florensg/cansat-utn-frre/docs/README.md

# Documentación del proyecto CanSat

Índice de la documentación técnica y de gestión del equipo UTN FRRe para el CanSat
Universitario 2026-2027.

## Estructura

### 00-gestion

Planificación, roles y listas de elementos.

- [Participantes y roles](00-gestion/participantes.md)
- [Decisión: repositorio único privado](00-gestion/decision-repo-bootstrap.md)
- [Decisión: controlador principal ESP32-S3](00-gestion/decision-controlador-esp32s3.md)
- [Planificación General v3](00-gestion/planificacion-general-v3.xlsx) — **vigente**
- [Elementos del CanSat v2](00-gestion/elementos-cansat-v2.xlsx) — **vigente**
- [Versiones anteriores archivadas](00-gestion/archivo/) — solo histórico, no usar

### 01-requisitos

Bases del certamen, reglamento, Anexo A y requisitos técnicos.

- [Propuesta Etapa 2 (borrador)](01-requisitos/propuesta-etapa-2-borrador.docx)
- [Requisitos técnicos organizados](01-requisitos/requisitos-tecnicos-organizado.docx)
- [Documentos de la competencia](01-requisitos/competencia/)

### 02-arquitectura

Arquitectura general, diagramas de sistemas y propuesta de circuito.

- [Diagramas de arquitectura y estados](02-arquitectura/diagramas/)
- [Propuesta de circuito CanSat](02-arquitectura/propuesta-circuito-cansat.pdf) — borrador
  preliminar; el controlador vigente es el ESP32-S3 (Elementos v2, C-002).

### 03-subsistemas

Documentación por subsistema y responsabilidad.

- [Software de vuelo — ISI 1](03-subsistemas/software-vuelo/README.md)
- [Determinación de actitud — ISI 1](03-subsistemas/actitud/README.md)
- [Software de misión secundaria — ISI 1](03-subsistemas/secundaria/README.md)
- [Comunicaciones — IEM 3 / ISI 2](03-subsistemas/comunicaciones/)
- [Resumen de Ingeniería de Software (borrador)](03-subsistemas/software-vuelo/resumen-ingenieria-software-borrador.docx)

### 04-pruebas

Planes de ensayo, matrices de verificación y evidencias.

- [Plan y matriz de pruebas](04-pruebas/README.md)

### 05-pdr

Material de la Preliminary Design Review.

- [Checklist y evidencias PDR](05-pdr/README.md)

## Convenciones

- Los documentos se nombran en minúsculas, sin acentos y con guiones.
- Las versiones nuevas de un documento de planificación se agregan como archivo nuevo y se
  indica cuál es la vigente en este índice.
- Las evidencias de ensayos se guardan en `04-pruebas/evidencias/` con el formato
  `AAAA-MM-DD_descripcion.ext`.
- Los datos personales (DNI, fecha de nacimiento, correos) no se versionan en este
  repositorio.
