florensg/cansat-utn-frre/docs/00-gestion/archivo/README.md

# Versiones anteriores de planificación y elementos

Este directorio conserva las versiones reemplazadas. **No deben usarse** para tomar
decisiones de diseño.

## Vigentes

- [`../planificacion-general-v3.xlsx`](../planificacion-general-v3.xlsx)
- [`../elementos-cansat-v2.xlsx`](../elementos-cansat-v2.xlsx)

## Histórico

- [`planificacion-general-v2.xlsx`](planificacion-general-v2.xlsx)
- [`elementos-cansat.xlsx`](elementos-cansat.xlsx)

El controlador principal vigente es el **ESP32-S3 DevKitC-1 de 44 pines** (C-002). El
STM32 (C-001) está descartado. Ver
[`../decision-controlador-esp32s3.md`](../decision-controlador-esp32s3.md).
