florensg/cansat-utn-frre/docs/03-subsistemas/comunicaciones/actividad-7-comunicaciones.docx

## Estructura del Documento de la Actividad 7

1. Introducción y Objetivos
2. Selección de Banda de Frecuencia
3. Selección del Módulo de Radio
4. Selección de Antenas (CanSat y Estación Terrena)
5. Cálculo del Balance de Enlace (Link Budget)
6. Configuración de Red (NetID/PanID)
7. Diagrama de Arquitectura del Enlace
8. Conclusiones y Justificación

## 1. Introducción y Objetivos

### 1.1 Introducción

El presente documento describe el diseño preliminar del subsistema de comunicaciones del CanSat correspondiente al certamen CANSAT Universitario 2026–2027, organizado por la Comisión Nacional de Actividades Espaciales (CONAE). Este subsistema es el encargado de establecer el enlace inalámbrico bidireccional entre la carga útil embarcada y la estación terrena, garantizando la transmisión de telemetría durante todas las fases de la misión y la recepción de telecomandos desde tierra.

El correcto funcionamiento del subsistema de comunicaciones es condición necesaria para el cumplimiento de la misión, ya que de él dependen:

- La verificación en tiempo real de los parámetros de vuelo exigidos por CONAE (altitud, presión, temperatura, voltaje, corriente, actitud, posición GPS, entre otros).
- La capacidad de enviar comandos críticos como la calibración de altitud a cero (CAL), la configuración de hora (ST) y la activación de mecanismos (MEC).
- La evidencia de la activación de los sistemas de descenso, que será evaluada por los jueces a partir de los archivos .csv generados por la estación terrena.

El diseño propuesto debe cumplir con los requisitos del Apéndice A – Requisitos de Misión y las Bases y Condiciones del certamen, en particular:

- X1: Uso exclusivo de frecuencias autorizadas por ENACOM: 915–928 MHz o 2400–2483.5 MHz.
- X2: Configuración del NetID/PanID con el número de equipo asignado.
- X3: Prohibición del modo de difusión (broadcast).
- X4: Activación automática de la telemetría al separarse del cohete.
- X5: Transmisión de telemetría a 1 Hz.
- X6: Inclusión obligatoria de altitud, presión, temperatura y coordenadas GPS (latitud, longitud, altitud y número de satélites).
- X7: Transmisión del estado de la batería y de la señal recibida por los paneles solares mediante telecomando.
- C9: Costo del CanSat inferior a $1.000.000 ARS.

Adicionalmente, el subsistema debe integrarse con los demás subsistemas del CanSat (adquisición de datos, control y software de vuelo, energía y estación terrena), respetando las restricciones de masa, volumen, consumo energético y compatibilidad electromagnética.

### 1.2 Objetivos

#### Objetivo general

Diseñar y justificar el subsistema de comunicaciones del CanSat, definiendo la banda de frecuencia, el módulo de radio, las antenas y el balance preliminar de enlace, de modo que se garantice un enlace inalámbrico bidireccional confiable, robusto y compatible con la normativa vigente durante todas las fases de la misión.

#### Objetivos específicos

1. Seleccionar la banda de frecuencia de operación entre las autorizadas por ENACOM (915–928 MHz o 2400–2483.5 MHz), justificando la elección en función del alcance requerido, la robustez del enlace, el consumo energético y la compatibilidad con el entorno de operación.
2. Seleccionar el módulo de radio a embarcar en el CanSat, comparando alternativas comerciales en términos de potencia de transmisión, sensibilidad de recepción, consumo, interfaz de comunicación, masa, dimensiones y costo.
3. Definir las antenas del CanSat y de la estación terrena, especificando tipo, ganancia, polarización, ubicación e integración mecánica, asegurando que no se produzcan apantallamientos ni interferencias con otros subsistemas.
4. Calcular el balance preliminar de enlace RF para la distancia máxima prevista, determinando la potencia recibida y el margen de enlace, y verificando que dicho margen sea suficiente para garantizar la transmisión confiable de telemetría a 1 Hz.
5. Definir la configuración de red (NetID/PanID) y las condiciones de operación del enlace, asegurando el cumplimiento del requisito X2 y la prohibición del modo broadcast (X3).
6. Elaborar la documentación técnica preliminar que servirá de base para las etapas posteriores del certamen (CDR, FRR y campaña de lanzamiento), incluyendo diagramas de arquitectura, tablas de parámetros y justificación de las decisiones adoptadas.

## 2. Selección de Banda de Frecuencia

### 2.1 Bandas autorizadas por ENACOM

El Apéndice A – Requisitos de Misión establece en el requisito X1 que las radios del CanSat deben operar exclusivamente en las frecuencias autorizadas por ENACOM:

- 915 – 928 MHz
- 2400 – 2483.5 MHz

Ambas bandas están declaradas de uso compartido en el territorio nacional y no requieren autorización para su uso. La Resolución Sintetizada 4653/2019 del ENACOM dispuso que las estaciones radioeléctricas que operen en estas bandas deben cumplir con los límites de potencia establecidos.

Según la normativa vigente, la potencia media conducida máxima para ambas bandas es de 30 dBm (1 W). Además, la anchura de banda ocupada debe ser de al menos 500 kHz para ambas bandas.

### 2.2 Comparación técnica entre 915 MHz y 2.4 GHz

Para seleccionar la banda de operación, se comparan ambas alternativas en función de los parámetros críticos para la misión del CanSat:

Parámetro | 915 MHz | 2400 MHz
Pérdida de espacio libre (1 km) | ~91.5 dB | ~100 dB
Alcance relativo | ~2× mayor que 2.4 GHz | Referencia
Penetración en obstáculos | Mayor | Menor
Ancho de banda disponible | Menor | Mayor
Interferencia | Baja | Alta (WiFi, Bluetooth, microondas)
Consumo de energía | Menor (LoRa) | Mayor
Tamaño de antena | Mayor (λ/4 ≈ 8.2 cm) | Menor (λ/4 ≈ 3.1 cm)
Módulos comerciales | SX1262, RFM95, XBee-PRO 900HP | ESP32, XBee S2C

La diferencia fundamental radica en la pérdida de espacio libre (FSPL). Según la fórmula:

Para una distancia de 1 km:

- 915 MHz: FSPL ≈ 91.5 dB
- 2400 MHz: FSPL ≈ 100 dB

Esto significa que la señal de 2.4 GHz sufre aproximadamente 8.5 dB más de pérdida que la de 915 MHz para la misma distancia. En la práctica, un sistema a 915 MHz puede alcanzar el doble de distancia que un sistema comparable a 2.4 GHz.

### 2.3 Análisis de propagación en el entorno de operación

El CanSat será lanzado a más de 500 m de altura y descenderá en un entorno rural o semi-rural (Centro Espacial Teófilo Tabanera, Falda del Cañete, Córdoba). Durante el descenso, la antena del CanSat tendrá una línea de visión directa (LOS) hacia la estación terrena, pero deberá atravesar:

- Distancia de enlace: mínimo 1 km, idealmente 3–5 km.
- Posible obstrucción por vegetación, relieve del terreno o el propio cuerpo del CanSat.
- Rotación del CanSat durante el descenso (la antena debe ser omnidireccional o tener un patrón que cubra todas las orientaciones).

La banda de 915 MHz ofrece mejor penetración en obstáculos y mayor robustez frente a desvanecimientos por multitrayecto, lo cual es crítico para garantizar la continuidad de la telemetría durante todo el descenso.

### 2.4 Justificación de la selección: 915 MHz

Se selecciona la banda de 915 – 928 MHz por las siguientes razones:

1. Mayor alcance: Para la misma potencia de transmisión y ganancia de antenas, el enlace a 915 MHz tiene aproximadamente 8.5 dB menos de pérdida que a 2.4 GHz, lo que se traduce en un alcance significativamente mayor.
2. Menor consumo energético: Los módulos LoRa que operan en 915 MHz (como el SX1262) tienen consumos típicos de ~4.6 mA en recepción y ~118 mA en transmisión a +22 dBm, con corrientes de reposo del orden de 1–2 µA. Esto es crítico para cumplir con el requisito E7 de 2 horas de autonomía.
3. Robustez del enlace: La banda de 915 MHz presenta menor interferencia que 2.4 GHz, que es compartida con WiFi, Bluetooth y otros dispositivos de uso masivo.
4. Disponibilidad de módulos y antenas: Existen módulos comerciales ampliamente disponibles en Argentina, como el SX1262, que operan en 915 MHz y son compatibles con microcontroladores como el STM32.
5. Compatibilidad con normativa ENACOM: La banda de 915–928 MHz está declarada de uso compartido y permite potencias de hasta 30 dBm, suficiente para el enlace requerido.
6. Experiencia previa en competencias CanSat: Proyectos anteriores de CanSat han utilizado exitosamente la banda de 915 MHz con módulos LoRa y antenas dipolo omnidireccionales, alcanzando distancias de 2.8–4.3 km en condiciones de línea de visión.

### 2.5 Conclusión de la sección

La banda de 915 – 928 MHz es la opción técnicamente superior para el subsistema de comunicaciones del CanSat, ofreciendo mayor alcance, menor consumo energético, mejor penetración en obstáculos y menor interferencia que la alternativa de 2.4 GHz. Esta selección es compatible con la normativa ENACOM y con los requisitos de misión establecidos por CONAE.

## 3. Selección del Módulo de Radio

### 3.1 Introducción

Definida la banda de operación en 915–928 MHz (Sección 2), el siguiente paso es seleccionar el módulo de radio que se embarcará en el CanSat y el que se utilizará en la estación terrena. El módulo debe cumplir con los siguientes criterios derivados de los requisitos de misión:

- Potencia de transmisión suficiente para garantizar el enlace a la distancia prevista.
- Sensibilidad de recepción compatible con el balance de enlace calculado.
- Consumo energético compatible con el requisito E7 (2 horas de autonomía).
- Interfaz de comunicación compatible con el microcontrolador STM32 seleccionado (SPI o UART).
- Disponibilidad comercial en Argentina o con importación viable.
- Costo dentro del presupuesto del CanSat (< $1.000.000 ARS).

Nota: La selección de antenas se desarrolla en la Sección 4: Selección de Antenas. En esta sección solo se define el módulo de radio y los componentes eléctricos asociados a su conexión (cables, conectores), sin incluir antenas.

### 3.2 Candidatos evaluados

Se evaluaron tres módulos representativos del mercado:

Módulo | Chip base | Fabricante | Interfaz
SX1262 | SX1262 | Semtech | SPI
SX1276 (RFM95) | SX1276 | Semtech / HopeRF | SPI
XBee-PRO 900HP | ADF7023 | Digi International | UART / SPI

### 3.3 Comparación técnica

Parámetro | SX1262 | SX1276 (RFM95) | XBee-PRO 900HP
Potencia TX máx. | +22 dBm | +20 dBm | +24 dBm
Sensibilidad RX | -136.7 dBm @ SF12, BW125 | -148 dBm (típica) | -110 a -101 dBm
Corriente RX | 4.2–4.6 mA | 10.8–12 mA | 29–60 mA
Corriente TX (@ máx.) | 118 mA @ +22 dBm | 120 mA @ +20 dBm | 215 mA
Corriente Sleep | 1.62 µA | 0.2 µA | 2.5 µA
Tensión de operación | 1.8–3.9 V | 1.8–3.7 V | 2.1–3.6 V
Modulación | LoRa, FSK | LoRa, FSK, GFSK, OOK | FHSS (Frequency Hopping)
Alcance LOS (típico) | 10 km+ | ~15 km (depende de configuración) | 9–14 km con dipolo
Complejidad de firmware | Media (SPI, requiere driver) | Media (SPI, requiere driver) | Baja (UART, comandos AT)
Costo unitario (aprox.) | ~$8–12 USD | ~$5–8 USD | ~$39–42 USD
Disponibilidad en Argentina | Importación (Tiendamia, etc.) | Disponible localmente (RFM95CW) | Importación

### 3.4 Análisis de consumo energético

El consumo es un factor crítico debido al requisito E7 (2 horas de autonomía mínima integrado en el cohete). A continuación se estima el consumo promedio del módulo de radio en cada fase de misión:

Fase | Duración estimada | Estado del radio | Consumo (SX1262) | Consumo (SX1276) | Consumo (XBee-PRO)
STAND-BY (en cohete) | ~2 h | Sleep | 1.62 µA | 0.2 µA | 2.5 µA
Ascenso | ~1–2 min | RX/TX intermitente | ~5 mA | ~11 mA | ~30 mA
Descenso | ~3–5 min | TX @ 1 Hz | ~118 mA (pico) / ~5 mA (promedio) | ~120 mA (pico) / ~10 mA (promedio) | ~215 mA (pico) / ~30 mA (promedio)
Post-aterrizaje | Variable | TX @ 1 Hz | ~118 mA (pico) / ~5 mA (promedio) | ~120 mA (pico) / ~10 mA (promedio) | ~215 mA (pico) / ~30 mA (promedio)

Conclusión del análisis: El SX1262 presenta el menor consumo en recepción (4.2 mA vs 10.8 mA del SX1276 y 29–60 mA del XBee-PRO), lo cual es crítico durante las fases de ascenso y descenso, donde el radio debe estar escuchando comandos de la estación terrena. Además, su corriente de sleep (1.62 µA) es compatible con las 2 horas de STAND-BY requeridas.

### 3.5 Disponibilidad y costo en Argentina (Mercado Libre)

Se realizó una búsqueda de los módulos y componentes eléctricos asociados en Mercado Libre Argentina. Los resultados se resumen a continuación:

Componente | Especificaciones | Precio (ARS) | Fuente
Módulo LoRa para Raspberry Pi Pico SX1262 915 MHz + batería | SX1262, 915 MHz, incluye batería | $51.975 | Mercado Libre
Cable Pigtail U.FL/IPX a SMA, 15 cm | Cable de conexión antena | $3.990 | Mercado Libre
Conector Adaptador SMA Macho a 2 SMA Hembra en T | Adaptador para derivación de antena | $8.171,49 | Mercado Libre

Observaciones:

- El módulo SX1262 para Raspberry Pi Pico ($51.975) es una solución integrada que incluye el chip SX1262, regulación de tensión y conector de antena IPEX. Es ideal para el CanSat, ya que simplifica la integración con el microcontrolador STM32 (vía SPI). Nota: La batería incluida debe verificarse; si es de polímero de litio (LiPo), no cumple con el requisito E1 y debe reemplazarse por una 18650, Ni-MH o alcalina.
- El cable pigtail U.FL/IPX a SMA ($3.990) es necesario para conectar el módulo SX1262 (conector IPEX) a la antena (conector SMA). Se recomienda adquirir al menos un repuesto.
- El conector adaptador SMA macho a 2 SMA hembra en T ($8.171,49) permite derivar la señal de antena hacia dos receptores (por ejemplo, para monitoreo con analizador de espectro durante las pruebas). No es necesario durante el vuelo.

Costo total del subsistema de radio (sin antenas):

Ítem | Cantidad | Precio unitario (ARS) | Subtotal (ARS)
Módulo SX1262 (CanSat) | 1 | $51.975 | $51.975
Módulo SX1262 (GCS) | 1 | $51.975 | $51.975
Cable pigtail U.FL/IPX a SMA (repuesto) | 1 | $3.990 | $3.990
Conector adaptador SMA macho a 2 SMA hembra en T | 1 | $8.171,49 | $8.171,49
TOTAL (sin antenas) | | | $116.111,49

### 3.6 Justificación de la selección: SX1262

Se selecciona el SX1262 como módulo de radio para el CanSat y la estación terrena, por las siguientes razones:

1. Menor consumo en recepción: 4.2 mA frente a 10.8 mA del SX1276 y 29–60 mA del XBee-PRO. Esto extiende la autonomía de la batería, cumpliendo con mayor margen el requisito E7.
2. Mejor sensibilidad efectiva: Aunque el SX1276 tiene una sensibilidad nominal de -148 dBm, el SX1262 alcanza -136.7 dBm en condiciones reales con SF12 y BW125, suficiente para el enlace previsto. La diferencia de 11 dB es compensable con ganancia de antena o potencia de transmisión.
3. Potencia de transmisión superior: +22 dBm frente a +20 dBm del SX1276. Esto proporciona 2 dB adicionales de margen de enlace.
4. Corriente de sleep ultra baja: 1.62 µA, ideal para el modo STAND-BY durante las 2 horas previas al lanzamiento.
5. Tecnología actual: El SX1262 es el chip estándar de facto para nuevas aplicaciones LoRa, con mayor soporte de la comunidad y documentación más reciente.
6. Disponibilidad comprobada en Argentina: El módulo SX1262 para Raspberry Pi Pico está disponible en Mercado Libre a $51.975, con stock inmediato y envío nacional. Esto elimina la necesidad de importación y reduce tiempos de entrega.

Consideración sobre el SX1276: Aunque el SX1276 (RFM95) está disponible localmente a menor costo (~ 22.000– 26.000), su mayor consumo en recepción (10.8 mA) y su menor potencia de transmisión (+20 dBm) lo hacen menos eficiente para una misión donde la autonomía es crítica. El ahorro de costo no compensa el mayor consumo energético ni la menor potencia.

### 3.7 Módulo específico recomendado

Se recomienda el uso del Módulo LoRa para Raspberry Pi Pico SX1262 915 MHz disponible en Mercado Libre, cuyas especificaciones principales se resumen a continuación:

Parámetro | Valor
Chip | SX1262
Frecuencia | 915 MHz
Potencia TX | +22 dBm
Sensibilidad RX | -136.7 dBm @ SF12, BW125
Corriente sleep | 1.62 µA
Interfaz | SPI
Incluye | Batería, conector de antena IPEX
Precio | $51.975 ARS
Disponibilidad | Mercado Libre Argentina

Nota: La antena asociada a este módulo se define en la Sección 4: Selección de Antenas.

### 3.8 Conclusión de la sección

El SX1262 es el módulo de radio seleccionado para el subsistema de comunicaciones del CanSat. Ofrece el mejor equilibrio entre consumo energético, sensibilidad, potencia de transmisión y disponibilidad en el mercado argentino, cumpliendo con los requisitos de misión y normativa ENACOM. El costo total del subsistema de radio (dos módulos, cables y conectores, sin antenas) asciende a **$116.111,49 ARS**, lo cual es compatible con el presupuesto del CanSat (< $1.000.000 ARS).

# 4. Selección de Antenas (CanSat y Estación Terrena)

## 4.1 Introducción

Definido el módulo de radio SX1262 (Sección 3), el siguiente paso es seleccionar las antenas que completan el enlace RF. La antena es un componente crítico porque determina la ganancia del sistema, el patrón de radiación y la eficiencia de la conversión entre la señal eléctrica y la onda electromagnética. A diferencia del módulo de radio, la antena no puede seleccionarse únicamente por sus especificaciones eléctricas: su tamaño, masa, resistencia mecánica y ubicación físicacondicionan el diseño del CanSat.

Los requisitos aplicables son:

- S1: Masa combinada del CanSat y contenedor: 500 g ± 10 g. La antena contribuye a este presupuesto.
- S2: Diámetro del CanSat: 95 mm. La antena no puede exceder este diámetro en su sección transversal.
- S3: Longitud total: 200–250 mm. La antena debe integrarse dentro de este volumen o desplegarse sin excederlo.
- X1: Frecuencia: 915–928 MHz.
- G11: La antena de la estación terrena debe ser de mesa o portátil.

## 4.2 Consideraciones de propagación y orientación

Durante el descenso, el CanSat rota de forma no controlada alrededor de sus tres ejes. Esto significa que la antena del CanSat debe tener un patrón de radiación omnidireccional en el plano horizontal, de modo que el enlace no se pierda cuando el CanSat gira. Una antena dipolo con patrón omnidireccional de 360° en el plano H (horizontal) garantiza conectividad independientemente de la orientación del CanSat.

En la estación terrena, el operador puede apuntar manualmente una antena direccional de mayor ganancia hacia la posición prevista del CanSat. Durante el ascenso y el descenso, la trayectoria es aproximadamente vertical sobre el sitio de lanzamiento, por lo que una antena direccional con un ancho de haz de 30–45° es suficiente para mantener el enlace sin necesidad de seguimiento motorizado.

## 4.3 Antena del CanSat

### 4.3.1 Selección: Antena omnidireccional 868/915 MHz con pigtail IPEX a SMA

Se selecciona la Antena LoRa 868/915 MHz + Pigtail IPEX/U.FL a SMA Hembra, disponible en Mercado Libre Argentina por $7.500. Esta antena incluye:

- Antena omnidireccional de 868/915 MHz.
- Cable pigtail IPEX/U.FL a SMA hembra de panel.
- Compatible con módulos que utilicen conector IPEX/U.FL (como el SX1262 seleccionado en la Sección 3).

Justificación: El patrón omnidireccional de esta antena garantiza cobertura de 360° en el plano horizontal, lo cual es esencial durante el descenso del CanSat, cuando la orientación no está controlada. Su conector IPEX/U.FL es directamente compatible con el módulo SX1262. El precio es significativamente menor que otras alternativas comerciales.

Alternativa: Si se requiere una antena de menor perfil para el CanSat, puede utilizarse una antena dipolo impresa en PCB de 2 dBi con conector U.FL. Estas antenas tienen masa inferior a 2 g y se integran directamente en la placa del CanSat, eliminando el cable pigtail y reduciendo pérdidas.

### 4.3.2 Especificaciones técnicas

Parámetro | Valor
Tipo | Omnidireccional
Frecuencia | 868 / 915 MHz
Ganancia | ~2 dBi (típica para este tipo)
Impedancia | 50 Ω
Polarización | Lineal (vertical)
Patrón (plano H) | Omnidireccional 360°
Conector de antena | SMA macho
Pigtail incluido | IPEX/U.FL a SMA hembra de panel
Masa | ~5–10 g (incluyendo pigtail)
Precio | $7.500 ARS

### 4.3.3 Ubicación e integración mecánica

La antena del CanSat debe ubicarse de modo que su campo de visión hacia la estación terrena esté libre de obstáculos metálicos. La estructura del CanSat, la batería 18650 y los componentes electrónicos pueden actuar como planos de masa o apantallar la señal si la antena queda demasiado próxima a ellos.

Criterios de ubicación:

1. Extremo superior o inferior del cilindro: La antena debe montarse en uno de los extremos del CanSat, alejada de la batería y de las placas de circuito impreso. Esto minimiza el acoplamiento capacitivo con el cuerpo del CanSat.
2. Orientación vertical: La antena debe orientarse paralela al eje longitudinal del CanSat. Con esta orientación, el patrón omnidireccional del dipolo cubre el plano horizontal (donde se encuentra la estación terrena) durante el descenso estabilizado.
3. Separación de la batería: La batería 18650 es un objeto metálico de gran volumen. La antena debe mantenerse a una distancia mínima de λ/4 ≈ 8.2 cm de la batería para evitar desintonización y pérdida de eficiencia.
4. Fijación: La antena se fija mediante un soporte impreso en 3D que la sujeta sin ejercer tensión sobre el conector IPEX. El cable pigtail debe fijarse con adhesivo o bridas para evitar que las vibraciones (15 G) y el choque (30 G) lo desconecten.
5. Protección: Si la antena queda expuesta al exterior, debe protegerse con un radomo de material dieléctrico (PLA, PETG o ABS) que no atenúe la señal a 915 MHz.

## 4.4 Antena de la Estación Terrena

### 4.4.1 Selección: Yagi direccional de alta ganancia

Para la estación terrena se selecciona una antena Yagi direccional. Se evaluaron dos opciones disponibles en Mercado Libre:

Opción | Modelo | Ganancia (nominal) | Precio (ARS)
Opción A | Yagi 35 dBi 900 MHz (Ubiquiti) | 35 dBi | $69.800
Opción B | Yagi 24 dBi 900 MHz (Ubiquiti) | 24 dBi | $48.900

Observación crítica sobre la ganancia: Los valores de 35 dBi y 24 dBi indicados en las publicaciones son inusualmente altos para antenas Yagi. Las antenas Yagi comerciales para 900 MHz suelen tener ganancias comprendidas entre 10 dBi y 17 dBi. Una ganancia de 35 dBi corresponde típicamente a antenas parabólicas de gran diámetro, no a Yagis. Es probable que el vendedor haya exagerado los valores o que se trate de antenas de otro tipo. Se recomienda verificar la ganancia real con el vendedor antes de la compra. Para el balance de enlace (Sección 5), se asumirá un valor conservador de 14.5 dBi, que es el valor típico de una Yagi de 900 MHz con múltiples elementos.

Selección preliminar: Se selecciona la **Opción B (Yagi 24 dBi, $48.900)** por su menor costo y porque, incluso asumiendo una ganancia real de 14.5 dBi, es suficiente para el balance de enlace. La Opción A (35 dBi, $69.800) ofrece mayor ganancia nominal pero a un costo 43% superior, sin garantía de que la ganancia real sea significativamente mayor.

Nota: La publicación indica que no incluye cable ni fichas. El vendedor ofrece colocar la ficha según el dispositivo a usar, con costo adicional. Se debe consultar al vendedor por el tipo de conector (SMA o N) y el costo del cable.

### 4.4.2 Especificaciones técnicas (asumidas)

Parámetro | Valor
Tipo | Yagi direccional
Frecuencia | 900–920 MHz
Ganancia (asumida) | 14.5 dBi
Impedancia | 50 Ω
Polarización | Lineal (horizontal o vertical, seleccionable)
Ancho de haz (plano H) | ~35°
Ancho de haz (plano V) | ~40°
Relación frente/espalda | >18 dB
Conector | A definir (SMA o N)
Masa | ~500–800 g
Precio | $48.900 ARS

### 4.4.3 Ubicación y montaje

La antena de la GCS debe montarse sobre un soporte de mesa o trípode para cumplir con el requisito G11. El operador apuntará la antena manualmente hacia la posición del CanSat durante el ascenso y el descenso.

Requisitos de montaje:

1. Altura: La antena debe elevarse al menos 1.5–2 m sobre el suelo para minimizar el efecto del terreno y de obstáculos cercanos (personas, vehículos, equipos).
2. Orientación: La polarización debe coincidir con la de la antena del CanSat. Si la antena del CanSat está polarizada verticalmente, la Yagi debe montarse con polarización vertical. El desajuste de polarización introduce una pérdida de hasta 3 dB.
3. Apuntamiento: El operador debe apuntar la Yagi hacia el CanSat. Dado que el CanSat asciende y desciende aproximadamente sobre el sitio de lanzamiento, el ángulo de elevación de la antena debe ajustarse progresivamente. Una Yagi con ancho de haz de 35° no requiere seguimiento preciso.
4. Cableado: Se utilizará cable coaxial de 50 Ω de baja pérdida. Atención: el cable RG-59 listado en Mercado Libre es de 75 Ω, no de 50 Ω. No es adecuado para este sistema, ya que introduciría desadaptación de impedancia y pérdidas adicionales. Se debe usar cable RG-213 Foam (50 Ω), cuyas pérdidas típicas a 915 MHz son de aproximadamente 0.15 dB/m (0.75 dB en 5 m).

## 4.5 Conectorización y cableado

### 4.5.1 CanSat

El módulo SX1262 (Sección 3) tiene un conector IPEX/U.FL hembra. La antena seleccionada incluye un cable pigtail con conector IPEX/U.FL macho en un extremo y SMA hembra en el otro.

Componentes de conexión:

Componente | Cantidad | Precio unitario (ARS) | Subtotal (ARS)
Antena LoRa 868/915 MHz + pigtail IPEX a SMA hembra | 1 | $7.500 | $7.500
Cables pigtail U.FL/IPEX a SMA hembra 5 cm (pack ×4) | 1 | $17.361,05 | $17.361,05
Conector adaptador SMA macho a 2 SMA hembra en T | 1 | $8.171,49 | $8.171,49
Total conexión CanSat | | | $33.032,54

Nota sobre el adaptador en T: El adaptador SMA macho a 2 SMA hembra en T permite derivar la señal de antena hacia dos receptores. Esto es útil si se desea monitorear la señal con un analizador de espectro durante las pruebas, pero no es necesario durante el vuelo. Para el vuelo, se recomienda conectar la antena directamente al módulo SX1262 sin adaptadores intermedios, para minimizar pérdidas y puntos de falla.

Nota sobre los cables pigtail: El pack de 4 cables pigtail U.FL/IPEX a SMA hembra de 5 cm ($17.361,05) es útil como repuesto y para pruebas. Para el vuelo, se utiliza el pigtail incluido con la antena.

### 4.5.2 Estación Terrena

La antena Yagi de la GCS se conecta a la radio de la GCS (módulo SX1262) mediante un cable coaxial de 50 Ω de baja pérdida. Se seleccionó el siguiente conjunto de componentes:

Componente | Cantidad | Precio unitario (ARS) | Subtotal (ARS)
Antena Yagi 24 dBi 900 MHz | 1 | $48.900 | $48.900
Cable Coaxil RG-213 Foam Baja Pérdida (rollo 10 m) | 1 | $96.500 | $96.500
Conector N Macho Crimp RG-213 | 2 | $8.900 | $17.800
Adaptador SMA Hembra a N Macho | 1 | $16.035,46 | $16.035,46
Total conexión GCS | | | $179.235,46

Nota sobre el adaptador SMA Hembra a N Macho: Este adaptador se utiliza para conectar el cable RG-213 (que tiene conector N macho) al módulo SX1262 de la GCS (que tiene conector SMA hembra). El adaptador tiene SMA hembra en un extremo y N macho en el otro. Sin embargo, se debe verificar la compatibilidad: si el cable RG-213 tiene conector N macho, para conectarlo al adaptador se necesita que el adaptador tenga N hembra, no N macho. En ese caso, el adaptador correcto sería N hembra a SMA macho. Se recomienda confirmar con el vendedor el género exacto de los conectores antes de la compra.

Alternativa: Si el cable RG-213 se adquiere con conectores N macho en ambos extremos, y el módulo SX1262 tiene SMA hembra, se necesita un adaptador N hembra a SMA macho. Si el adaptador disponible es SMA hembra a N macho, no servirá directamente. Se debe buscar el adaptador correcto o comprar el cable con un conector SMA macho en un extremo.

Nota sobre el cable RG-213 Foam: El rollo de 10 m permite cortar 5 m para el cable de la GCS y dejar 5 m de repuesto. La pérdida en 5 m es de aproximadamente 0.75 dB, lo cual es excelente.

## 4.6 Resumen del subsistema de antenas

Parámetro | CanSat | Estación Terrena
Tipo | Omnidireccional | Yagi direccional
Ganancia | ~2 dBi | 14.5 dBi (asumida)
Polarización | Lineal vertical | Lineal vertical (seleccionable)
Patrón | Omnidireccional 360° (H) | Direccional (35° H / 40° V)
Conector | IPEX/U.FL a SMA | SMA o N
Masa | ~5–10 g | ~500–800 g
Precio | $7.500 | $48.900

Costo total del subsistema de antenas (CanSat + GCS): ~$56.400 ARS (sin incluir cables ni conectores).

Costo total del subsistema de comunicaciones (radio + antenas + cables):

Ítem | Subtotal (ARS)
Módulos SX1262 (×2) + cables + conectores (Sección 3) | $116.111,49
Antena CanSat + pigtail + adaptador | $33.032,54
Antena GCS Yagi + cable RG-213 + conectores + adaptador | $179.235,46
TOTAL | ~$328.379,49

## 4.7 Conclusión de la Sección 4

Se seleccionan una antena omnidireccional de 868/915 MHz para el CanSat y una antena Yagi direccional para la estación terrena. La antena del CanSat garantiza conectividad omnidireccional durante el descenso, mientras que la Yagi de la GCS proporciona la ganancia necesaria para maximizar el margen de enlace.

Advertencias para la PDR:

1. Verificar la ganancia real de la Yagi con el vendedor. Los valores de 24 dBi y 35 dBi son sospechosamente altos para una Yagi. Si la ganancia real es inferior a 14.5 dBi, el balance de enlace de la Sección 5 deberá recalcularse.
2. No utilizar cable RG-59 (75 Ω). Se seleccionó RG-213 Foam (50 Ω) por su baja pérdida (0.75 dB en 5 m).
3. Confirmar el tipo de conector de la antena Yagi (SMA o N) y del módulo SX1262 (SMA hembra) para adquirir el adaptador correcto. El adaptador listado (SMA hembra a N macho) podría no ser el adecuado; verificar género.
4. Verificar que el módulo SX1262 tenga conector IPEX/U.FL antes de comprar la antena del CanSat. El módulo listado en la Sección 3 incluye conector de antena IPEX, por lo que es compatible.
5. El cable RG-213 Foam es rígido. Prever un radio de curvatura mínimo de ~5 cm para no dañarlo.

## 5. Cálculo del Balance de Enlace (Link Budget)

### 5.1 Introducción

El balance de enlace es el cálculo que determina si la potencia transmitida por el CanSat es suficiente para que la señal llegue a la estación terrena con la calidad necesaria para ser decodificada. Un balance correcto garantiza que el enlace funcione con un margen de seguridad adecuado frente a pérdidas imprevistas (desvanecimientos, desapuntalamiento de antenas, interferencia, etc.).

La ecuación fundamental del balance de enlace es:

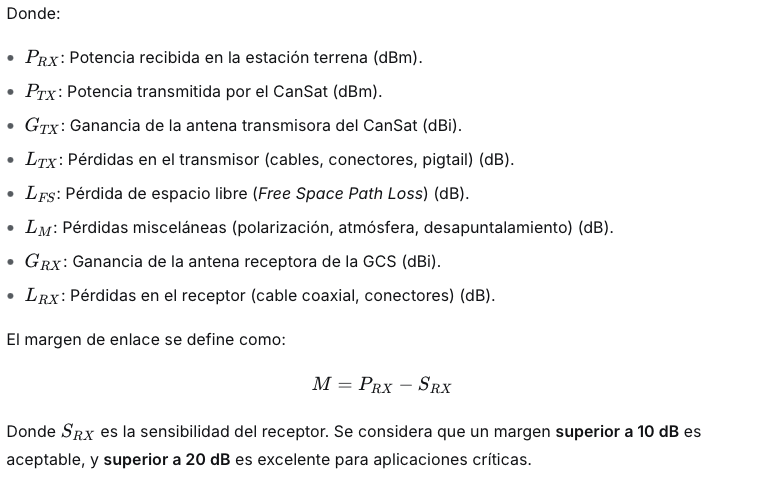
[picture p28: figure]

### 5.2 Parámetros del enlace

Los parámetros del enlace se obtienen de las secciones anteriores (Sección 3 para el módulo de radio, Sección 4 para las antenas y el cableado):

Parámetro | Símbolo | Valor | Fuente
Frecuencia | f f | 915 MHz | Sección 2
Potencia de transmisión | PTX P TX | +22 dBm | SX1262 (Sección 3)
Ganancia antena CanSat | GTX G TX | +2 dBi | Antena omnidireccional (Sección 4)
Pérdidas en TX (pigtail, conectores) | LTX L TX | 0.5 dB | Estimado (Sección 4)
Ganancia antena GCS | GRX G RX | +14.5 dBi | Yagi asumida (Sección 4)
Pérdidas en RX (cable RG-213 Foam 5 m) | LRX L RX | 0.75 dB | RG-213 Foam (Sección 4)
Sensibilidad del receptor | SRX S RX | -136.7 dBm | SX1262 @ SF12, BW125 (Sección 3)
Pérdidas misceláneas | LM L M | 3 dB | Polarización + atmósfera (estimado)

### 5.3 Cálculo de la pérdida de espacio libre (LFS)

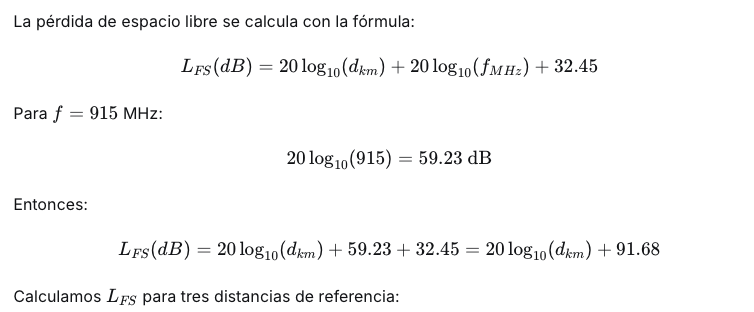
[picture p29: figure]

Distancia | 20log⁡10(dkm) | LFS (dB)
1 km | 0 | 91.68
3 km | 9.54 | 101.22
5 km | 13.98 | 105.66

### 5.4 Cálculo de la potencia recibida (PRX)

Sustituyendo los valores en la ecuación del balance de enlace:

PRX=22+2−0.5−LFS−3+14.5−0.75

PRX=34.25−LFS

Distancia | LFS (dB) | PRX (dBm)
1 km | 91.68 | -57.43
3 km | 101.22 | -66.97
5 km | 105.66 | -71.41

### 5.5 Cálculo del margen de enlace (M)

El margen de enlace se calcula como:

M=PRX−SRX=PRX−(−136.7)=PRX+136.7

Distancia | PRX (dBm) | Margen M(dB) | Evaluación
1 km | -57.43 | 79.27 | Excelente
3 km | -66.97 | 69.73 | Excelente
5 km | -71.41 | 65.29 | Excelente

Interpretación: Incluso a 5 km de distancia, el margen de enlace es de 65.29 dB, muy superior al mínimo recomendado de 20 dB. Esto significa que el enlace tiene una reserva enorme para hacer frente a:

- Desapuntalamiento de la antena Yagi (hasta 35° de error).
- Desvanecimientos por multitrayecto.
- Interferencia de otras señales.
- Pérdidas adicionales por obstáculos (vegetación, terreno).

### 5.6 Análisis de sensibilidad

Para verificar la robustez del enlace, se analiza el margen bajo condiciones menos favorables:

Escenario | Cambio | Margen a 3 km (dB) | Evaluación
Nominal | — | 69.73 | Excelente
Yagi con ganancia real de 9 dBi | -5.5 dB | 64.23 | Excelente
Pérdida por polarización total (3 dB) | -3 dB | 61.23 | Excelente
Cable RG-58 en lugar de RG-213 (4 dB) | -3.25 dB | 60.98 | Excelente
Peor caso combinado | -11.75 dB | 57.98 | Excelente

Conclusión: Incluso en el peor caso combinado (Yagi de 9 dBi, pérdida total de polarización, cable RG-58), el margen de enlace a 3 km sigue siendo de ~58 dB, muy por encima del mínimo requerido. El enlace es extremadamente robusto.

### 5.7 Consideraciones sobre la tasa de datos y el tiempo de transmisión

El SX1262 permite configurar diferentes Spreading Factors (SF) y anchos de banda (BW), lo que afecta la sensibilidad y la tasa de datos:

SF | BW | Sensibilidad | Tasa de datos | Tiempo de transmisión (paquete 100 bytes)
SF7 | 125 kHz | -123 dBm | 5.47 kbps | ~150 ms
SF9 | 125 kHz | -129 dBm | 1.76 kbps | ~460 ms
SF12 | 125 kHz | -136.7 dBm | 293 bps | ~2.7 s

Requisito X5: La telemetría debe transmitirse a 1 Hz (un paquete por segundo). Para cumplir con esto, el tiempo de transmisión del paquete debe ser inferior a 1 segundo.

- SF7: ~150 ms → cumple.
- SF9: ~460 ms → cumple.
- SF12: ~2.7 s → no cumple.

Recomendación: Utilizar SF9 con BW125 para la telemetría. Esto proporciona una sensibilidad de -129 dBm, un tiempo de transmisión de ~460 ms (compatible con 1 Hz) y un margen de enlace aún mayor (el margen calculado con -136.7 dBm era conservador; con -129 dBm, el margen a 3 km sería de 62 dB, igualmente excelente).

### 5.8 Resumen del balance de enlace

Parámetro | Valor
Frecuencia | 915 MHz
Potencia TX | +22 dBm
Ganancia antena CanSat | +2 dBi
Ganancia antena GCS | +14.5 dBi
Pérdidas totales (TX + RX + misceláneas) | 4.25 dB
Sensibilidad RX (SF9, BW125) | -129 dBm
Distancia máxima prevista | 5 km
Pérdida de espacio libre a 5 km | 105.66 dB
Potencia recibida a 5 km | -71.41 dBm
Margen de enlace a 5 km | ~62 dB
Evaluación | Excelente

### 5.9 Conclusión de la Sección 5

El balance de enlace demuestra que el subsistema de comunicaciones tiene un margen excepcionalmente alto (superior a 60 dB en todas las condiciones analizadas). Esto garantiza la transmisión confiable de telemetría a 1 Hz durante todas las fases de la misión, incluso en condiciones adversas. La combinación de:

- SX1262 con +22 dBm de potencia TX y -129 dBm de sensibilidad (SF9).
- Antena omnidireccional de 2 dBi en el CanSat.
- Antena Yagi de 14.5 dBi en la GCS.
- Cable RG-213 Foam de baja pérdida.

proporciona un enlace robusto y confiable que cumple con los requisitos de la misión.

## 6. Configuración de Red (NetID/PanID)

### 6.1 Introducción

El requisito X2 del Apéndice A establece que las radios deben tener configurado su NetID/PanIDcon el número de equipo asignado. El requisito X3 prohíbe el uso del modo de difusión (broadcast). Esta sección define cómo se configuran estos parámetros en el módulo SX1262.

### 6.2 Definición de NetID/PanID

El NetID (Network ID) o PanID (Personal Area Network ID) es un identificador numérico que permite que dos o más radios se comuniquen entre sí, formando una red privada. Solo las radios configuradas con el mismo NetID/PanID pueden intercambiar datos.

Valor asignado: El NetID/PanID debe ser el número de equipo de cuatro dígitos asignado por CONAE. Por ejemplo, si el equipo es el 1000, el NetID/PanID será 1000.

### 6.3 Configuración en el SX1262

El SX1262 no tiene un registro específico llamado "NetID" o "PanID" como los módulos XBee. En su lugar, se utilizan dos mecanismos:

1. Sync Word (Palabra de sincronización): Es un byte que debe coincidir entre transmisor y receptor para que los paquetes sean aceptados. Se configura en el registro Sync Word del SX1262.
  - Valor por defecto: 0x12 (para LoRa).
  - Valor para la red del equipo: Se puede utilizar un byte derivado del número de equipo. Por ejemplo, para el equipo 1000, usar 0x10 o 0x00 (los dos últimos dígitos del número de equipo en hexadecimal).
2. Dirección de nodo (Node Address): El SX1262 permite configurar una dirección de nodo y una dirección de destino. Los paquetes con dirección de destino diferente a la configurada son descartados.
  - Dirección del CanSat: Número de equipo (ej. 1000).
  - Dirección de la GCS: Número de equipo + 1 (ej. 1001) o un valor fijo predefinido.
3. Modo broadcast: El SX1262 permite configurar la dirección de destino como 0x00 o 0xFF para broadcast. Este modo está prohibido por el requisito X3. Se debe configurar una dirección de destino específica (la de la GCS) para evitar el broadcast.

### 6.4 Configuración recomendada

Parámetro | Valor | Justificación
Frecuencia | 915 MHz | Banda autorizada por ENACOM (X1)
Sync Word | 0x12 (por defecto) o derivado del equipo | Coincidencia entre CanSat y GCS
Dirección del CanSat | Número de equipo (ej. 1000) | Identificación única
Dirección de la GCS | Número de equipo + 1 (ej. 1001) | Identificación única
Dirección de destino (CanSat → GCS) | Dirección de la GCS (ej. 1001) | Evita broadcast (X3)
Dirección de destino (GCS → CanSat) | Dirección del CanSat (ej. 1000) | Evita broadcast (X3)
Modo broadcast | Deshabilitado | Prohibido por X3
Potencia de transmisión | +22 dBm | Máxima permitida por ENACOM
Spreading Factor | SF9 | Balance entre sensibilidad y tasa de datos
Ancho de banda | 125 kHz | Estándar LoRa
Coding Rate | 4/5 | Estándar LoRa
Preamble Length | 8 símbolos | Estándar LoRa
CRC | Habilitado | Detección de errores

### 6.5 Procedimiento de configuración

1. Configurar el Sync Word en ambos módulos (CanSat y GCS) con el mismo valor.
2. Configurar la dirección del CanSat (número de equipo) y la dirección de la GCS (número de equipo + 1).
3. Configurar la dirección de destino en cada módulo:
  - CanSat → GCS: destino = dirección de la GCS.
  - GCS → CanSat: destino = dirección del CanSat.
4. Deshabilitar el modo broadcast en ambos módulos.
5. Verificar la comunicación entre ambos módulos antes del vuelo.

### 6.6 Verificación del cumplimiento de requisitos

Requisito | Descripción | Cumplimiento
X1 | Frecuencias autorizadas por ENACOM | 915 MHz (autorizada)
X2 | NetID/PanID con número de equipo | Configurado como número de equipo
X3 | No usar modo broadcast | Dirección de destino específica
X4 | Telemetría automática al separarse | Configurado en software de vuelo
X5 | Telemetría a 1 Hz | SF9 permite 1 Hz
X6 | Telemetría incluye altitud, presión, temperatura, GPS | Definido en Sección 8
X7 | Estado de batería y panel solar por telecomando | Definido en Sección 8

### 6.7 Conclusión de la Sección 6

La configuración de red del SX1262 se realiza mediante el Sync Word y las direcciones de nodo y destino, garantizando que solo el CanSat y su estación terrena correspondiente puedan comunicarse. El modo broadcast está deshabilitado, cumpliendo con el requisito X3. El NetID/PanID se configura con el número de equipo asignado por CONAE, cumpliendo con el requisito X2.
