florensg/cansat-utn-frre/docs/03-subsistemas/software-vuelo/resumen-ingenieria-software-borrador.docx

# Resumen de Ingeniería de Software: Proyecto CanSat

Responsable: Florencia González (ISI 1) - Ingeniería en Sistemas de Información

Subsistemas a cargo: Control y Software de Vuelo, Telemetría, Determinación de Actitud

## 1. Alcance y Responsabilidades (ISI 1)

De acuerdo a la planificación oficial del equipo, tus responsabilidades abarcan tres áreas críticas:

- Misión Principal (Software de Vuelo): Eres responsable de la arquitectura de hardware y software del OBC (computadora de a bordo). Esto incluye programar la máquina de estados, la telemetría, la gestión de fallas/reinicios (usando FRAM, RTC y Watchdog) y el algoritmo de vuelo (detección de apogeo y del 80% de la altura máxima para abrir el paracaídas).
- Misión Secundaria (Determinación de Actitud): Debes diseñar el algoritmo matemático de fusión sensorial combinando los datos de la IMU, el magnetómetro y los sensores solares. Además, gestionarás la comunicación y sincronización de estos datos con el procesador secundario de imágenes.
- Sistema de Alimentación: Implementarás la gestión por software de los perfiles de consumo energético, leyendo los datos del sensor INA219 para monitorear el estado de la batería.

## 2. Decisiones Arquitectónicas de Hardware y Software

Componente / Tema | Decisión Técnica Recomendada | Justificación de Ingeniería
Microcontrolador Principal (OBC) | STM32 (Familia Cortex-M) | Cuenta con Acceso Directo a Memoria (DMA) para no bloquear el procesador al escribir datos, Watchdog independiente por hardware (IWDG) para máxima robustez y un RTC nativo alimentado por batería.
Procesamiento de Imágenes | Placa Secundaria (Ej. ESP32-CAM o RPi Zero) | El STM32 no tiene suficiente RAM para almacenar fotos o matrices pesadas. Separar el hardware asegura que el procesamiento de imágenes no congele al chip principal y bloquee la apertura del paracaídas.
Inteligencia Artificial | TinyML en placa secundaria | Modelos grandes (como Ollama o LLMs) son inviables por masa y consumo de batería, y carecen de determinismo de respuesta. Usar TinyML (TensorFlow Lite o Edge Impulse) en el procesador secundario permite clasificar el terreno sin arriesgar la misión de vuelo.
Entorno de Programación | PlatformIO (C/C++) | Supera al IDE de Arduino tradicional; permite una gestión rigurosa de dependencias, un mejor autocompletado y una estructura orientada a Sistemas Operativos en Tiempo Real (RTOS).

## 3. Plan de Desarrollo Incremental en 5 Fases

1. Fase 1: Entorno y Arquitectura Base: Creación del proyecto en PlatformIO y programación del esqueleto lógico de la Máquina de Estados Finita (FSM) de manera no bloqueante.
2. Fase 2: Adquisición y Telemetría Básica: Lectura simultánea del barómetro y la IMU, ensamblado de la trama de datos CSV y configuración del temporizador para enviar la telemetría a exactamente 1 Hz.
3. Fase 3: Manejo de Fallas y Reinicios: Programación del guardado de variables críticas en la memoria FRAM, lectura continua del reloj RTC de respaldo y configuración del temporizador Watchdog para recuperarse de cualquier microcorte eléctrico.
4. Fase 4: Lógica Crítica de Descenso: Codificación del algoritmo matemático que detectará la pérdida constante de altitud (apogeo) y disparará las señales a los mecanismos de liberación al pasar la barrera del 80%.
5. Fase 5: Misión Secundaria y Optimización: Fusión de los sensores de orientación, transmisión de los datos etiquetados (altitud, actitud, GPS) a la placa de imágenes por el puerto serial y programación de estados de reducción de consumo energético.

## 4. Próximos Pasos

- Estructurar gráficamente el diagrama de la Máquina de Estados (estados y condiciones de transición).
- Coordinar con Juan (IEM 3) el pinout definitivo del STM32 y los buses de comunicación (I2C/SPI) a utilizar.
- Acordar con Agustín (ISI 2) el formato final de la trama de telemetría y el protocolo de intercambio de datos entre la placa principal y la secundaria.
