florensg/cansat-utn-frre/docs/03-subsistemas/comunicaciones/README.md

# Comunicaciones — IEM 3 / ISI 2

Responsables: Juan Pedro López (IEM 3) y Agustín Brites (ISI 2).

Esta carpeta contiene la documentación del subsistema de comunicaciones: selección de
banda, módulo de radio, antenas, balance de enlace y configuración de red.

## Documentos

- [Actividad 7 — Comunicaciones](actividad-7-comunicaciones.docx)

## Interfaz con software de vuelo

El contrato de telemetría y comandos se define junto con ISI 1 y se documenta en:

- [`docs/03-subsistemas/software-vuelo/README.md`](../software-vuelo/README.md)
- [`gcs/README.md`](../../../gcs/README.md)

Los puntos abiertos son la trama CSV definitiva, el formato de `OPTIONAL_DATA` y el acuse
de comandos.
