florensg/cansat-utn-frre/docs/00-gestion/participantes.md

# Participantes y roles

Equipo de la UTN Facultad Regional Resistencia para el CanSat Universitario 2026-2027.

## Integrantes

| Integrante | Carrera | Rol | Responsabilidad principal |
|---|---|---|---|
| Florencia González | Ingeniería en Sistemas de Información | ISI 1 | Software de vuelo, telemetría y determinación de actitud |
| Agustín Brites | Ingeniería en Sistemas de Información | ISI 2 | Estación terrena, datos y procesamiento de imágenes |
| Juan Pedro López | Ingeniería Electromecánica | IEM 3 | Electrónica, sensores y RF |
| Catriel Paz | Ingeniería Electromecánica | IEM 1 | Sistema de alimentación |
| Maximiliano López | Ingeniería Electromecánica | IEM 2 | Descenso y recuperación |
| Luciana Cáceres | Ingeniería Electromecánica | IEM 4 | Mecánica y estructura |

Docente responsable: Raimundo Vázquez.

## Reglas de trabajo

1. Cada subsistema tiene un responsable principal, pero toda interfaz entre misión
   principal, misión secundaria y alimentación se revisa en conjunto.
2. IEM 1 lidera el sistema de alimentación; IEM 4 verifica la integración mecánica y la
   masa; ISI 1 aporta los modos de operación y la gestión de consumo por software.
3. IEM 3 e ISI 1 coordinan la adquisición, la electrónica y la fusión sensorial. ISI 2
   lidera el procesamiento de datos e imágenes.
4. IEM 4 verifica la integración mecánica de cámaras y sensores secundarios. IEM 2 apoya
   cuando hay interacción con el descenso o la recuperación.
5. Desde la semana 6 el trabajo se orienta a integración, pruebas cruzadas y evidencias
   para la PDR.

## Datos personales

La documentación de identidad (DNI, certificados, fechas de nacimiento y correos) no se
versiona en este repositorio. Se conserva en el Drive del equipo.
