florensg/cansat-utn-frre/docs/02-arquitectura/Propuesta 2 de circuito cansat.jpeg

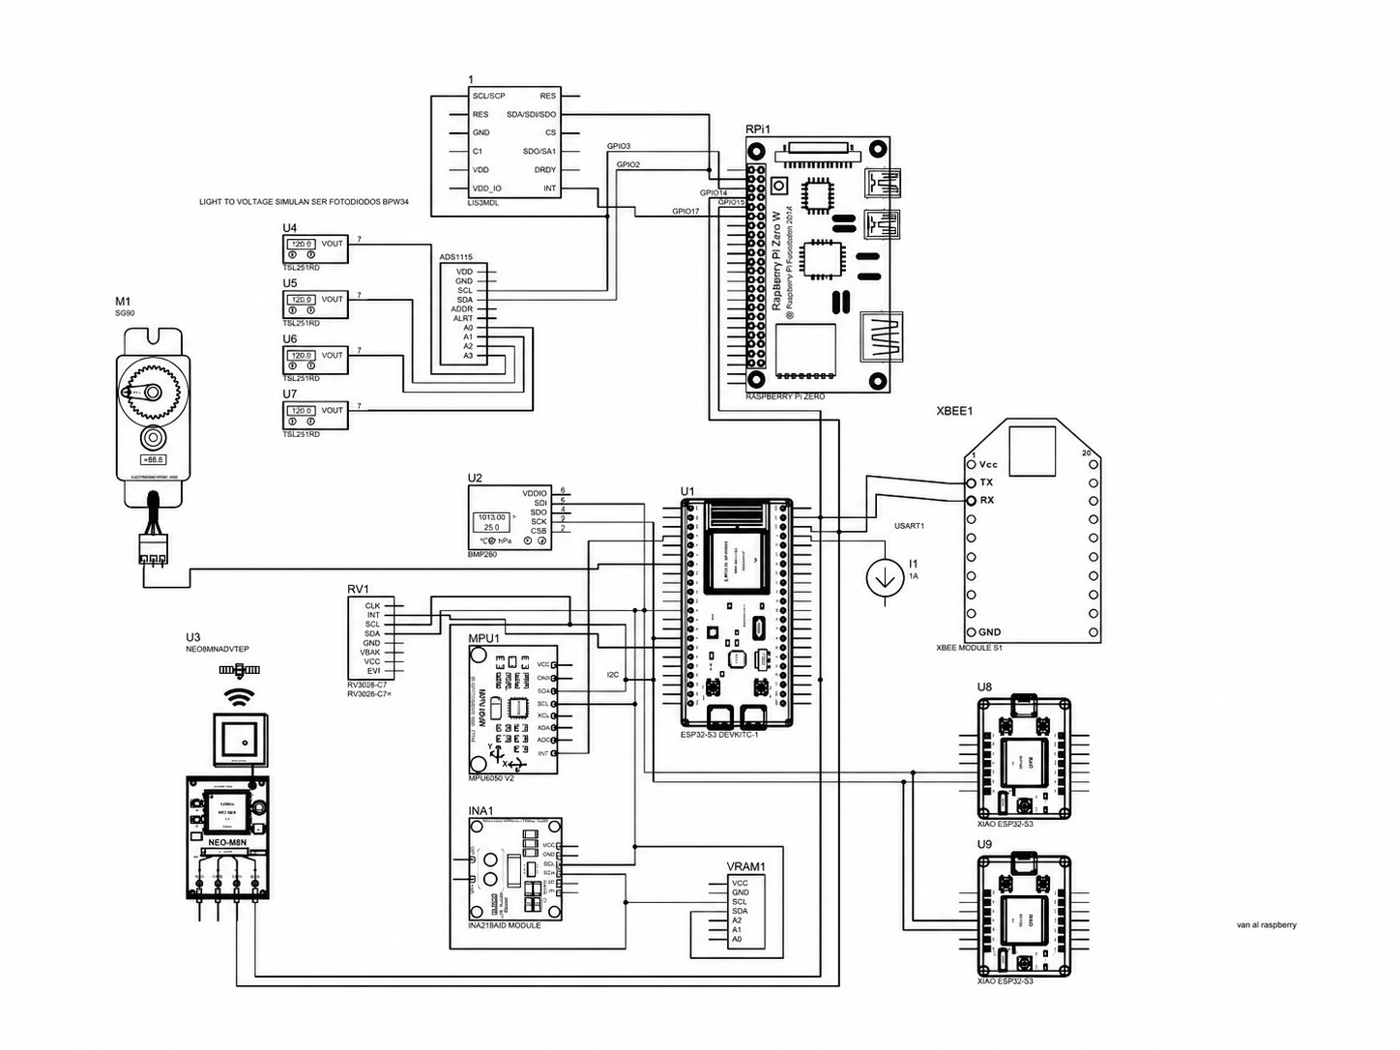
docs/02-arquitectura/Propuesta 2 de circuito cansat.jpeg
