florensg/cansat-utn-frre/docs/00-gestion/elementos-cansat-v2.xlsx

Sheet: Resumen
CanSat Universitario 2026–2027 | Control de masa, energía y presupuesto
Parámetros de diseño |  |  | Batería seleccionada
Masa objetivo [g] | 500 |  | Modelo | Samsung INR21700
Tolerancia de masa [g] | 10 |  | Tensión pack [V] | 3.63
Presupuesto máximo CanSat [ARS] | $1000000 |  | Capacidad pack [mAh] | 9800.00
Autonomía mínima [h] | 2 |  | Energía utilizable [Wh] | 32.02
Margen energético de diseño [%] | 20% |  | Masa pack [g] | 139.00
Eficiencia global de regulación [%] | 85% |  | Costo pack [ARS] | $0
 |  |  | N.º candidatas seleccionadas | 1
Indicadores principales
Masa total CanSat + batería [g] | 235.5 |  | Cómo usar la planilla
Estado masa | REVISAR |  | 1. Cargar cada sensor, módulo, pieza mecánica y elemento de estación terrena en «Componentes».
Costo CanSat + batería [ARS] | $0 |  | 2. Completar tensión, corrientes y duty activo para estimar potencia media.
Presupuesto restante [ARS] | $1000000 |  | 3. Cargar candidatos de batería en «Baterias» y marcar solo uno como «Sí».
Potencia media a bordo [W] | 4.07 |  | 4. La masa y costo del CanSat incluyen solo filas marcadas «Computa en CanSat? = Sí» más la batería seleccionada.
Energía requerida con margen [Wh] | 11.49 |  | 5. Los parámetros editables del cuadro superior pueden modificarse si CONAE actualiza requisitos o si se adopta otro margen de diseño.
Autonomía batería seleccionada [h] | 2.37
Estado autonomía | CUMPLE
Masa disponible hasta 510 g [g] | 274.5
Subsistema | Masa [g] | Costo [ARS] | Potencia [W]
Adquisición de datos | 22.0 | $0 | 0.023
Control / Software | 36.8 | $0 | 3.175
Comunicación | 8.0 | $0 | 0.639
Navegación | 8.0 | $0 | 0.082
Registro / Video | 19.0 | $0 | 0.000
Almacenamiento | 2.7 | $0 | 0.001
Mecánico / Estructural | 0.0 | $0 | 0.000
Descenso / Recuperación | 0.0 | $0 | 0.150
Misión secundaria | 0.0 | $0 | 0.000
Otros | 0.0 | $0 | 0.000
Batería seleccionada | 139.0 | $0 | 0.000
Costos fuera del límite C9
Costo estación terrena / soporte [ARS] | $0
Costo total del proyecto [ARS] | $0

Sheet: Componentes
ID | Subsistema | Computa en CanSat? | Aplicación | Tipo | Componente / Modelo | Función | Cantidad | Tensión [V] | Corriente activa [mA] | Corriente reposo [mA] | Duty activo [%] | Corriente media [mA] | Potencia media [W] | Masa unitaria [g] | Masa total [g] | Precio unitario [ARS] | Costo total [ARS] | Interfaz | Protocolo / Frecuencia | Estado | Fuente / Link | Notas
C-001 | Control / Software | Sí | Común | Microcontrolador | STM32 | Unidad principal de control | 1 | 3.30 | 36.000000 | 5.50 | 100.00% | 36.0000 | 0.118800 | 8.0 | 8.0 |  | $0 |  |  | Descartado
C-002 | Control / Software | Sí | Común | Microcontrolador | ESP32-S3 | Unidad principal de control | 1 | 3.30 | 47.300000 | 36.10 | 100.00% | 47.3000 | 0.156090 | 15.0 | 15.0 |  | $0 |  |  | Seleccionado | https://naylampmechatronics.com/espressif-esp/1206-esp32-s3-devkitc-1-44-pin-esp32-s3-wifi-usb-c.html
C-003 | Adquisición de datos | Sí | Misión principal | Sensor | BMP280 | Presión / temperatura / altitud barométrica | 1 | 3.30 | 0.720000 | 0.0001 | 0.38% | 0.0028 | 0.000009 | 2.0 | 2.0 |  | $0 | I2C / SPI |  | Seleccionado
C-004 | Adquisición de datos | Sí | Misión principal | IMU | GY-521 | Aceleración y velocidad angular | 1 | 5.00 | 3.900000 | 0.01 | 100.00% | 3.9000 | 0.019500 | 2.1 | 2.1 |  | $0 | I2C / SPI |  | Seleccionado
C-005 | Navegación | Sí | Misión principal | GPS | NEO-M8N | Posición, altitud y tiempo GPS | 1 | 3.00 | 34.000000 | 0.03 | 80.00% | 27.2060 | 0.081618 | 8 | 8.0 |  | $0 | UART |  | Seleccionado
C-006 | Comunicación | Sí | Común | Radio | XBee-Pro 900HP | Telemetría y telecomandos | 1 | 3.30 | 215.000000 | 0.01 | 90.00% | 193.5010 | 0.638553 | 8.0 | 8.0 |  | $0 | SPI / UART | 915–928 MHz o 2.4 GHz | Seleccionado
C-007 | Registro / Video | Sí | Misión principal | Cámara | Xiao ESP32SE Sense - OV2640 | Registro de video hacia cenit / nadir | 2 | 5.00 | 140.000000 | 38.30 |  |  |  | 8 | 16.0 |  | $0 |  |  | Seleccionado
C-008 | Almacenamiento | Sí | Común | Memoria | MicroSD 8GB | Respaldo de telemetría / datos | 3 | 3.30 |  |  |  |  |  | 0.5 | 1.5 |  | $0 | SPI |  | Seleccionado
C-009 | Descenso / Recuperación | Sí | Misión principal | Mecanismo |  | Liberación del segundo sistema de descenso | 1 |  |  |  |  |  |  |  |  |  |  |  |  | Por definir
C-010 | Descenso / Recuperación | Sí | Misión principal | Baliza | Diyables X5 | Baliza audible independiente | 1 | 5.00 | 30.000000 | 0.001 | 100.00% | 30.0000 | 0.150000 |  | 0.0 |  | $0 |  |  | Seleccionado
C-011 | Mecánico / Estructural | Sí | Común | Estructura |  | Estructura / contenedor del CanSat | 1 |  |  |  |  |  |  |  |  |  |  |  |  | Por definir
C-012 | Mecánico / Estructural | Sí | Común | Cableado / conectores |  | Cableado, conectores y fijaciones | 1 |  |  |  |  |  |  |  |  |  |  |  |  | Por definir
C-013 | Adquisición de datos | Sí | Misión principal | Sensor solar | Panel Solar Epóxico | Detección de radiación solar exigida por CONAE | 1 |  |  |  |  |  |  | 14.0 | 14.0 |  | $0 |  |  | Candidato | https://www.sdgreensun.com/products_detail.php?cid=88&id=228&utm_source=chatgpt.com
C-014 | Misión secundaria | Sí | Misión secundaria | Sensor / módulo |  | Hardware específico de la misión secundaria | 1 |  |  |  |  |  |  |  |  |  |  |  |  | Por definir
G-001 | Estación terrena | No | Común | Radio |  | Radio de estación terrena | 1 |  |  |  |  |  |  |  |  |  |  |  |  | Por definir
G-002 | Estación terrena | No | Común | Antena |  | Antena de estación terrena | 1 |  |  |  |  |  |  |  |  |  |  |  |  | Por definir
G-003 | Estación terrena | No | Común | Computadora |  | Computadora portátil / GCS | 1 |  |  |  |  |  |  |  |  |  |  |  |  | Por definir
C-015 | Adquisición de datos | Sí | Misión principal | Sensor | INA219 | Medición de Batería | 1 | 3.30 | 0.700000 | 0.01 | 100.00% | 0.7000 | 0.002310 | 2.0 | 2.0 |  | $0 |  |  | Seleccionado
C-016 | Almacenamiento | Sí | Común | Memoria | FRAM I2C | Memoria no Volatil | 1 | 3.30 | 0.200000 | 0.03 | 100.00% | 0.2000 | 0.000660 | 1.2 | 1.2 |  | $0 |  |  | Seleccionado
C-017 | Adquisición de datos | Sí | Misión secundaria | Sesnsor | LIS3MDL | Determinación de Orientación (Magnetómetro) | 1 | 3.30 | 0.270000 | 0.001 | 100.00% | 0.2700 | 0.000891 | 1.5 | 1.5 |  | $0 |  |  | Seleccionado
C-018 | Adquisición de datos | Sí | Misión secundaria | Sensor | BPW34 (Fotodiodo) | Intensidad de Luz Solar | 4 | 0.00 | 0.000000 | 0.00 | 0.00% | 0.0000 | 0.000000 | 0.1 | 0.4 |  | $0 |  |  | Seleccionado
C-019 | Control / Software | Sí | Común | Conversor AD | ADS1115 | Convertir señal de diodos | 1 | 3.30 | 0.150000 | 0.0005 | 100.00% | 0.1500 | 0.000495 | 1.8 | 1.8 |  | $0 |  |  | Seleccionado
C-020 | Registro / Video | Sí | Misión secundaria | Cámara Infrarroja | IMX219 NoIR | Registro de video hacia nadir | 1 |  |  |  |  |  |  | 3.0 | 3.0 |  | $0 |  |  | Seleccionado | https://www.raspberrypi.com/documentation/accessories/camera.html
C-021 | Control / Software | Sí | Misión secundaria | Microprocesador | Raspberry Pi Zero 2W | Procesamiento de videos y datos | 1 | 5.00 | 580.000000 | 280.00 | 100.00% | 580.0000 | 2.900000 | 12.0 | 12.0 |  | $0 |  |  | Seleccionado
C-022 | Control / Software | Sí | Común | Reloj | RV 3028 C7 | Respaldo de hora para microcontrolador | 1 | 3.00 | 0.000045 | 4.5e-05 | 100.00% | 4.5e-05 | 1.35e-07 | 0.0114 | 0.0114 |  | $0 |  |  | Seleccionado
 |  |  |  |  |  | La baliza lleva alimentación aparte

Sheet: Baterias
Seleccionada | Modelo | Química | Tensión celda [V] | Capacidad celda [mAh] | Serie (S) | Paralelo (P) | Tensión pack [V] | Capacidad pack [mAh] | Energía nominal [Wh] | Fracción utilizable [%] | Energía utilizable [Wh] | Masa celda [g] | Masa extra pack [g] | Masa total pack [g] | Precio celda [ARS] | Costo extra pack [ARS] | Costo total pack [ARS] | Autonomía estimada [h] | Margen sobre mínimo [h] | Estado autonomía | Observaciones
No | Murata US18650VTC6 | Li-ion 18650 | 3.70 | 3000.00 | 1 | 3 | 3.70 | 9000.00 | 33.30 | 90% | 29.97 | 46.6 |  | 139.8 |  |  |  | 2.22 | 0.22 | CUMPLE
No | Samsung INR18650 | Li-ion 18650 INR | 3.60 | 3600.00 | 1 | 3 | 3.60 | 10800.00 | 38.88 | 90% | 34.99 | 50.0 |  | 150.0 |  |  |  | 2.59 | 0.59 | CUMPLE | https://www.eybms.com/es/product/bateria-samsung-inr18650-de-36-g-3600-mah-y-10-a/
No | Molicel INR-21700-P45B | Li-ion 21700 INR | 3.60 | 4500.00 | 1 | 2 | 3.60 | 9000.00 | 32.40 | 90% | 29.16 | 70.0 |  | 140.0 |  |  |  | 2.16 | 0.16 | CUMPLE
Sí | Samsung INR21700 | Li-ion 21700 INR | 3.63 | 4900.00 | 1 | 2 | 3.63 | 9800.00 | 35.57 | 90% | 32.02 | 69.5 |  | 139.0 |  |  |  | 2.37 | 0.37 | CUMPLE
No |  |  |  |  | 1 | 1 |  |  |  | 90%
No |  |  |  |  | 1 | 1 |  |  |  | 90%
No |  |  |  |  | 1 | 1 |  |  |  | 90%
No |  |  |  |  | 1 | 1 |  |  |  | 90%
No |  |  |  |  | 1 | 1 |  |  |  | 90%

Sheet: Requisitos_CONAE
Requisito | Tema | Descripción | Valor útil para la planilla | Fuente
S1 | Masa | La masa combinada del CanSat y el contenedor debe ser de 500 g ± 10 g. | Objetivo 500 g; rango permitido 490–510 g | Apéndice A – Requisitos de Misión
S2 | Dimensiones | El diámetro del CanSat debe ser de 95 mm. | Ø 95 mm | Apéndice A – Requisitos de Misión
S3 | Dimensiones | La longitud total, incluidos los sistemas de descenso, debe estar entre 200 y 250 mm. | 200–250 mm | Apéndice A – Requisitos de Misión
C9 | Presupuesto | El costo del CanSat debe ser inferior a $1.000.000. Herramientas de análisis y soporte en tierra no incluidas. | < $1.000.000 ARS para el CanSat | Apéndice A – Requisitos de Misión
E1 | Batería | No se permiten baterías de polímero de litio. | LiPo no permitida | Apéndice A – Requisitos de Misión
E2 | Batería | Se permiten alcalinas, Ni-Cd, Ni-MH o litio con empaque metálico tipo 18650; también baterías de botón. | Usar química permitida | Apéndice A – Requisitos de Misión
E7 | Autonomía | El CanSat debe funcionar durante un mínimo de dos horas cuando esté integrado en el cohete. | Autonomía mínima: 2 h | Apéndice A – Requisitos de Misión
M4 | Conexión batería | No se deben utilizar contactos de resorte para realizar conexiones eléctricas a las baterías. | Evitar portapilas con contacto de resorte | Apéndice A – Requisitos de Misión

Sheet: Presupuesto de masa
Presupuesto de masa — distribución actual y objetivo |  |  |  |  | Sistema | Masa actual asignada [g] | Sistema | Masa objetivo [g]
La masa actual se calcula únicamente con los elementos ya cargados en la planilla. No se modifica ninguna hoja existente. Se excluye el STM32 marcado como descartado. |  |  |  |  | Estructura y contenedor | 0.0 | Estructura y contenedor | 125.0
 |  |  |  |  | Sistema de alimentación | 141.0 | Sistema de alimentación | 120.0
Indicador | Valor |  |  |  | Control y almacenamiento principal | 16.7 | Control y almacenamiento principal | 25.0
Masa objetivo nominal [g] | 500.0 |  |  |  | Sensores y navegación principal | 26.1 | Sensores y navegación principal | 30.0
Tolerancia reglamentaria [g] | 10.0 |  |  |  | Comunicaciones RF | 8.0 | Comunicaciones RF | 15.0
Límite superior [g] | 510.0 |  |  |  | Video + misión secundaria | 35.7 | Video + misión secundaria | 45.0
Masa actualmente asignada [g] | 227.5 |  |  |  | Descenso y recuperación | 0.0 | Descenso y recuperación | 65.0
Masa todavía no asignada [g] | 272.5 |  |  |  | Cableado, conectores y fijaciones | 0.0 | Cableado, conectores y fijaciones | 20.0
Porcentaje de masa ya asignada | 45.5% |  |  |  |  |  | Reserva / masa no asignada | 55.0
Sistema | Masa actual [g] | Masa objetivo [g] | Diferencia [g] | Objetivo [%]
Estructura y contenedor | 0.0 | 125.0 | 125.0 | 25.0%
Sistema de alimentación | 141.0 | 120.0 | -21.0 | 24.0%
Control y almacenamiento principal | 16.7 | 25.0 | 8.3 | 5.0%
Sensores y navegación principal | 26.1 | 30.0 | 3.9 | 6.0%
Comunicaciones RF | 8.0 | 15.0 | 7.0 | 3.0%
Video + misión secundaria | 35.7 | 45.0 | 9.3 | 9.0%
Descenso y recuperación | 0.0 | 65.0 | 65.0 | 13.0%
Cableado, conectores y fijaciones | 0.0 | 20.0 | 20.0 | 4.0%
Reserva / masa no asignada | 272.5 | 55.0 | -217.5 | 11.0%
TOTAL | 500.0 | 500.0 | 0.0 | 100.0%
Criterio de distribución
Estructura | Objetivo de 125 g para carcasa, tapas, bandejas, separadores y soportes.
Alimentación | Incluye batería seleccionada y, en la masa actual, el INA219. El objetivo reserva masa para regulación, BMS, interruptores y fuentes auxiliares.
Control | Incluye ESP32-S3 seleccionado, FRAM, RTC y una de las tres microSD.
Video + secundaria | Incluye las dos XIAO, Raspberry Pi Zero 2 W, IMX219 NoIR, LIS3MDL, ADS1115, BPW34 y dos microSD.
Reserva | La masa todavía no asignada muestra cuánto falta definir hasta 500 g; el objetivo final deja 55 g como margen/lastre.
