florensg/cansat-utn-frre/docs/00-gestion/planificacion-general-v3.xlsx

Sheet: Gantt PDR
CanSat Universitario 2026–2027 — Gantt previo a PDR | Misión Principal
Plan de 8 semanas para el desarrollo preliminar de la misión principal. Se complementa con las hojas de misión secundaria e integración general.
Duración | Integrantes | Actividades | Hitos | Inicio | Entrega PDR |  | Leyenda de responsabilidad
5 sem. | 6 | 23 | 3 | 2026-09-28 | 2026-10-26 |  | IEM |  |  | Mecánica / electrónica / descenso
 |  |  |  |  |  |  | ISI |  |  | Software / estación terrena
 |  |  |  |  |  |  | Compartido |  |  | Trabajo interdisciplinario
 |  |  |  |  |  |  | Integración / pruebas |  |  | Ensayos y cierre
N.º | Actividad | Responsable | Área | Dependencia | Estado
1 | Relevamiento y matriz de requisitos CONAE — Anexo A v2 | Todos | Compartido | — | Finalizado | ■ | ■
2 | Definición de misión, objetivos y CONOPS | Todos | Compartido | 1 | Finalizado | ■ | ■
3 | Interfaces y arquitectura general del CanSat | Todos | Compartido | 1–2 | Finalizado |  | ■ | ■
4 | Sensores, rangos, buses, muestreo y calibración | Lopez, Juan + Gonzalez, Flor | Compartido | 3 | En curso |  | ■ | ■ | ■
5 | Microcontrolador principal: arquitectura de hardware y software | Gonzalez, Flor + Lopez, Juan | Compartido | 3–4 | Finalizado |  | ■ | ■ | ■
6 | Lógica/estados internos de misión, persistencia, RTC, watchdog y reinicios | Gonzalez, Flor | ISI | 5 | Planificado |  |  | ■ | ■ | ■
7 | Radio, banda, antena y balance preliminar de enlace RF | Lopez, Juan + Brites, Agustin | Compartido | 3 | En curso |  | ■ | ■ | ■ | ■
8 | Telemetría 1 Hz (incl. aceleración/rotación 3 ejes), lógica automática al separarse y telecomandos | Gonzalez, Flor + Brites, Agustin | ISI | 5–7 | Planificado |  |  | ■ | ■ | ■
9 | Hardware y GUI preliminar de estación terrena | Brites, Agustin | ISI | 7 | Planificado |  | ■ | ■ | ■ | ■
10 | Decodificación, CSV, respaldo y contadores de paquetes | Brites, Agustin | ISI | 8–9 | Planificado |  |  |  | ■ | ■ | ■
11 | Dimensiones (Ø 90 mm), distribución interna y presupuesto de masa | Cáceres, Luciana | IEM | 3–4 | En curso |  | ■ | ■ | ■
12 | Materiales, CAD preliminar, sujeciones y estructura | Cáceres, Luciana | IEM | 11 | Planificado |  |  | ■ | ■ | ■
13 | Simulación preliminar de esfuerzos | Cáceres, Luciana + Lopez, Maximiliano | IEM | 12 | Planificado |  |  |  | ■ | ■ | ■
14 | Concepto de descenso y cálculo de dos paracaídas | Lopez, Maximiliano | IEM | 2–3 | En curso |  | ■ | ■ | ■
15 | Mecanismo de liberación, anclajes y líneas de suspensión | Lopez, Maximiliano + Cáceres, Luciana | IEM | 12–14 | Planificado |  |  | ■ | ■ | ■
16 | Algoritmo de detección del 80 % de la altura máxima | Gonzalez, Flor + Lopez, Maximiliano | Compartido | 6,14 | Planificado |  |  |  | ■ | ■
17 | Baliza de recuperación y alimentación independiente | Paz, Catriel + Lopez, Maximiliano | IEM | 14 | Planificado |  |  |  | ■ | ■
18 | Inventario de cargas y arquitectura del sistema de alimentación común | Paz, Catriel | IEM | 3–10 | En curso |  | ■ | ■
19 | Selección preliminar de batería, regulación, distribución, interruptores y protecciones | Paz, Catriel + Cáceres, Luciana | IEM | 18 | En curso |  |  | ■ | ■
20 | Cálculo de autonomía, eficiencia y margen energético; validación de medición con INA219 | Paz, Catriel + Lopez, Juan | IEM | 18–19 | Planificado |  |  |  | ■ | ■
21 | Prototipo preliminar de alimentación bajo cargas representativas y picos de consumo | Paz, Catriel + Lopez, Juan | Integración / pruebas | 19–20 | Planificado |  |  |  |  | ■ | ■
22 | Prototipos críticos: sensores, control, radio y GCS | Lopez, Juan + Gonzalez, Flor + Brites, Agustín | Integración / pruebas | 4–10,18–21 | Planificado |  |  |  | ■ | ■ | ■
23 | Pruebas preliminares de subsistemas | Todos | Integración / pruebas | 12–22 | Planificado |  |  |  |  | ■ | ■
24 | Integración preliminar hardware + software + alimentación | Lopez, Juan + Gonzalez, Flor + Paz, Catriel + Cáceres, Luciana | Integración / pruebas | 21–23 | Planificado |  |  |  |  |  | ■ | ■
25
26 | Armado de diapositivas PDR | Todos | Compartido | 25 | Planificado |  |  |  |  |  |  | ■ | ■
27 | Revisión cruzada y ensayo de presentación | Todos | Integración / pruebas | 26 | Planificado |  |  |  |  |  |  |  | ■
HITOS DE CONTROL
Hito 1 — Fin S2 | Requisitos, misión, CONOPS, arquitectura general y arquitectura energética preliminar definidos.
Hito 2 — Fin S5 | Diseño preliminar por subsistemas, balance energético y prototipos críticos en marcha.
Hito 3 — Fin S8 | PDR revisada, sistema de alimentación incorporado, presentación ensayada y documentación lista.

Sheet: Responsables
Equipo UTN FRRe — distribución de responsabilidades
Rol | Carrera | Integrante | Responsabilidad principal | Apoya en | Entregables clave
IEM 1 | Ingeniería Electromecánica | Paz, Catriel | Sistema de Alimentación | Distribución eléctrica, integración con electrónica, autonomía y protecciones | Batería, regulación, autonomía, protecciones, distribución eléctrica
IEM 2 | Ingeniería Electromecánica | Lopez, Maximiliano | Descenso y recuperación | Mecanismos, anclajes, ensayos y seguridad | Paracaídas, liberación, anclajes, baliza, pruebas
IEM 3 | Ingeniería Electromecánica | Lopez, Juan | Electrónica, sensores, y RF | Adquisición primaria/secundaria, interfaces, instrumentación | Sensores, radio, antena, buses e interfaces
IEM 4 | Ingeniería Electromecánica | Cáceres, Luciana | Mecánica y estructura | Integración física, masa, alojamiento de batería y sensores | CAD, materiales, distribución, sujeciones, esfuerzos, soporte de batería
ISI 1 | Ingeniería en Sistemas de Información | Gonzalez, Flor | Software de vuelo | Fusión sensorial, gestión de energía por software e integración | Microcontrolador principal, estados internos, reinicios, persistencia, actitud, modos de operación y software embarcado
ISI 2 | Ingeniería en Sistemas de Información | Brites, Agustin | Estación terrena y datos | Procesamiento multiespectral y clasificación | GUI, telemetría, CSV, procesamiento VIS/NIR y datos
Regla de trabajo recomendada
1 | Cada subsistema tiene un responsable principal, pero toda interfaz entre misión principal, secundaria y alimentación debe revisarse en conjunto.
2 | IEM 1 lidera el sistema de alimentación; IEM 4 verifica integración mecánica y masa, e ISI 1 aporta modos de operación y gestión de consumo.
3 | IEM 3 + ISI 1 coordinan adquisición, electrónica y fusión sensorial; ISI 2 lidera el procesamiento de datos e imágenes.
4 | IEM 4 verifica la integración mecánica de cámaras/sensores secundarios y IEM 2 apoya cuando haya interacción con descenso o recuperación.
5 | Desde la semana 6 el trabajo debe orientarse a integración, pruebas cruzadas y evidencias para la PDR.

Sheet: Entregables PDR
Entregables mínimos por subsistema antes de cerrar la PDR
Subsistema | Diseño / definición | Cálculo / análisis | Prototipo / prueba | Interfaz con otros | Responsable | Semana objetivo
Adquisición de datos | Sensores/cámaras, variables, buses, muestreo y calibración | Rangos, resolución y compatibilidad eléctrica | Lectura conjunta de sensores | Microcontrolador principal, alimentación, almacenamiento | Lopez, Juan + Gonzalez, Flor
Control y software de vuelo | Microcontrolador principal, memoria no volátil, RTC, watchdog y arquitectura de software | Lógica/estados internos y gestión de reinicios/persistencia | Firmware base + simulación de estados | Sensores, radio, actuadores y modos de energía | Gonzalez, Flor
Comunicación | Radio, banda, no-broadcast, telemetría 1 Hz (incl. IMU 3 ejes) y lógica automática de separación | Balance preliminar de enlace RF | Envío/recepción bidireccional | Microcontrolador principal + estación terrena + alimentación | Lopez, Juan + Brites, Agustin
Estación terrena | Hardware receptor + GUI | Decodificación, pérdida de paquetes, variables IMU y gestión de telecomandos | Recepción 1 Hz + CSV + telecomandos | Radio + software de vuelo | Brites, Agustin
Mecánico y estructural | CAD, materiales, distribución Ø 90 mm y sujeciones | Masa + esfuerzos preliminares | Mockup / fit preliminar | Todos los subsistemas físicos + alojamiento de batería | Cáceres, Luciana
Descenso y recuperación | Dos paracaídas, liberación, anclajes, baliza | Velocidades, geometría y criterio 80 % | Ensayo de mecanismo / caída preliminar | Software de vuelo + estructura + baliza independiente | Lopez, Maximiliano + Gonzalez, Flor
Alimentación de energía (común) | Batería permitida, regulación 3.3/5 V, distribución, interruptor, indicador y protecciones | Presupuesto de cargas, autonomía ≥2 h, eficiencia y margen energético | Prueba con cargas representativas, picos de consumo y lectura INA219 | Todos los subsistemas + VBAT RTC + baliza independiente | Paz, Catriel + Cáceres, Luciana + Gonzalez, Flor
Integración PDR | Arquitectura consolidada | Presupuesto de masa, energía, costo, riesgo y cronograma | Demostraciones de conceptos críticos | Todos | Todos
Nota: el sistema de alimentación se trata como subsistema común a misión principal y secundaria, y debe dimensionarse con la suma de consumos de ambas.
Base de planificación actualizada: Anexo A v2 y Bases y Condiciones vigentes. Ante diferencias, esta planificación adopta las modificaciones del Anexo A v2 según criterio del equipo.

Sheet: Gantt Mision Secundaria
CanSat Universitario 2026–2027 — Gantt previo a PDR | Misión Secundaria
Misión secundaria integrada: determinación de actitud magneto-solar-inercial + teledetección multiespectral + detección de zonas potencialmente aptas de aterrizaje.
Duración | Integrantes | Actividades | Hitos | Inicio | Entrega PDR |  | Leyenda
5 sem. | 6 | 24 | 3 | 2026-09-28 | 2026-10-26 |  | Hardware / sensores |  |  | IEM 3 + soporte IEM 4
 |  |  |  |  |  |  | Software / algoritmos |  |  | ISI 1 + ISI 2
 |  |  |  |  |  |  | Compartido |  |  | Trabajo interdisciplinario
 |  |  |  |  |  |  | Pruebas / integración |  |  | Validación conjunta
N.º | Actividad | Responsable | Área | Dependencia | Estado
1 | Definir objetivos, métricas de éxito y requisitos propios de la misión secundaria | Todos | Compartido | — | En curso | ■ | ■
2 | Definir arquitectura general e interfaces con la misión principal | Gonzalez, Flor + Lopez, Juan + Brites, Agustín | Compartido | 1 | Planificado | ■ | ■ | ■
3 | Seleccionar magnetómetro, sensores solares direccionales y cámara NIR | Lopez, Juan | Hardware / sensores | 1–2 | Finalizado |  | ■ | ■
4 | Definir rangos, muestreo, buses, acondicionamiento y calibración de sensores secundarios | Lopez, Juan | Hardware / sensores | 3 | Planificado |  | ■ | ■ | ■
5 | Diseñar integración mecánica de cámara NIR y sensores solares/magnéticos | Cáceres, Luciana + Lopez, Juan | Hardware / sensores | 3–4 | Planificado |  |  | ■ | ■ | ■
6 | Relevar tensiones, consumos medios/pico y modos de operación de la misión secundaria | Paz, Catriel + Lopez, Juan + Brites, Agustin | Compartido | 2–4 | En curso |  | ■ | ■ | ■
7 | Definir interfaz eléctrica de la misión secundaria con el sistema común de alimentación | Paz, Catriel + Lopez, Juan | Hardware / sensores | 5–6 | Planificado |  |  | ■ | ■ | ■
8 | Definir sistema de referencia, ejes y modelo de actitud | Gonzalez, Flor + Lopez, Juan | Software / algoritmos | 2–4 | Planificado |  | ■ | ■ | ■
9 | Desarrollar algoritmo de fusión IMU + magnetómetro + sensores solares | Gonzalez, Flor | Software / algoritmos | 8 | Planificado |  |  | ■ | ■ | ■
10 | Prototipo y validación de actitud con orientaciones conocidas | Gonzalez, Flor + Lopez, Juan | Pruebas / integración | 9 | Planificado
11 | Definir arquitectura de adquisición visible/NIR y sincronización de imágenes | Brites, Agustin + Lopez, Juan | Compartido | 2–4 | Planificado |  | ■ | ■ | ■
12 | Definir calibración y alineación geométrica VIS–NIR | Brites, Agustin + Cáceres, Luciana | Software / algoritmos | 5,11 | Planificado |  |  | ■ | ■ | ■
13 | Definir variables e índices multiespectrales a procesar | Brites, Agustin | Software / algoritmos | 11–12 | Planificado |  |  | ■ | ■ | ■
14 | Definir clases de terreno y criterios de aptitud de aterrizaje | Brites, Agustin + Cáceres, Luciana + Lopez, Maximiliano | Compartido | 1,13 | Planificado |  |  | ■ | ■ | ■
15 | Desarrollar algoritmo de segmentación y clasificación del terreno | Brites, Agustin + Gonzalez, Flor | Software / algoritmos | 13–14 | Planificado |  |  |  | ■ | ■ | ■
16 | Asociar resultados con GPS, altitud y actitud del CanSat | Gonzalez, Flor + Brites, Agustin | Software / algoritmos | 9,15 | Planificado |  |  |  |  | ■ | ■
17 | Definir procesador secundario y reparto de procesamiento a bordo / post-vuelo | Gonzalez, Flor + Brites, Agustin | Compartido | 2,11,15,6 | Planificado |  |  | ■ | ■ | ■
18 | Definir almacenamiento, formatos de datos e integración de resultados secundarios con telemetría | Brites, Agustin + Gonzalez, Flor | Software / algoritmos | 16–17 | Planificado |  |  |  | ■ | ■ | ■
19 | Prototipo crítico integrado: actitud + VIS/NIR + clasificación | Todos | Pruebas / integración | 10,15,18 | Planificado |  |  |  |  | ■ | ■ | ■
20 | Ensayos de sensores solares, magnetómetro y calibración | Lopez, Juan + Gonzalez, Flor | Pruebas / integración | 4,9 | Planificado |  |  |  | ■ | ■ | ■
21 | Ensayos VIS/NIR sobre superficies conocidas y validación de clasificación | Brites, Agustin + Cáceres, Luciana | Pruebas / integración | 12–15 | Planificado |  |  |  |  | ■ | ■ | ■ | ■
22 | Medición de consumo real de la misión secundaria y validación contra presupuesto energético | Paz, Catriel + Brites, Agustín + Lopez, Juan | Pruebas / integración | 6–7,17,19 | Planificado |  |  |  |  | ■ | ■ | ■
23
24 | Consolidar masa, consumo, riesgos, resultados preliminares y diapositivas PDR | Todos | Compartido | 23 | Planificado |  |  |  |  |  |  | ■ | ■
HITOS DE CONTROL
Hito 1 — Fin S2 | Objetivos, interfaces y requisitos eléctricos de la misión secundaria definidos.
Hito 2 — Fin S5 | Sensores, algoritmos y demanda energética preliminar definidos; prototipos en marcha.
Hito 3 — Fin S8 | Prueba integrada, consumo medido, resultados, masa/riesgos y material PDR consolidados.

Sheet: Entregables Secundaria
Entregables mínimos de la misión secundaria antes de cerrar la PDR
Sistema | Definición / diseño | Cálculo / algoritmo | Prototipo / prueba | Interfaz común | Responsable principal | Apoyo | Semana objetivo
Adquisición secundaria | Magnetómetro, sensores solares, cámara NIR, buses y calibración | Rangos, muestreo y acondicionamiento | Lectura estable y sincronizada | Microcontrolador principal, alimentación, almacenamiento | Lopez, Juan | Gonzalez, Flor + Cáceres, Luciana
Determinación de actitud | Sistema de referencia y fuentes de orientación | Fusión IMU + magnetómetro + Sol; Roll/Pitch/Yaw | Validación con orientaciones conocidas | IMU/GPS/tiempo de misión principal | Gonzalez, Flor | Lopez, Juan
Teledetección multiespectral | Arquitectura VIS/NIR, montaje y sincronización | Alineación, calibración e índices multiespectrales | Captura de superficies conocidas | Cámara nadir, GPS, altura | Brites, Agustin | Lopez, Juan + Cáceres, Luciana
Detección de zonas de aterrizaje | Clases y criterios de aptitud | Segmentación / clasificación / índice de aptitud | Validación sobre terreno conocido | VIS/NIR + actitud + GPS | Brites, Agustin | Gonzalez, Flor + Cáceres, Luciana + Lopez, Maximiliano
Control y software secundario | Procesador, arquitectura y reparto de tareas | Gestión de sensores, imágenes, errores y modos de consumo | Prototipo integrado de software | Computadora principal, telemetría y alimentación | Gonzalez, Flor | Brites, Agustin + Lopez, Juan
Interfaces con misión principal | Datos compartidos y protocolo interno | Sincronización y formato de datos secundarios | Intercambio estable de datos | GPS, altura, tiempo y telemetría | Gonzalez, Flor | Brites, Agustin + Lopez, Juan
Procesamiento y almacenamiento | Formatos, archivos, imágenes y resultados | Pipeline de postproceso y respaldo | Generación reproducible de resultados | microSD / GCS | Brites, Agustin | Gonzalez, Flor
Integración mecánica | Ubicación de cámara NIR y sensores secundarios | Campo de visión, masa y compatibilidad geométrica | Mockup / montaje preliminar | Estructura general del CanSat | Cáceres, Luciana | Lopez, Juan
Interfaz de alimentación secundaria | Tensiones, conectores, distribución y secuencia de encendido | Consumo medio/pico y presupuesto energético de la misión secundaria | Medición real de consumo bajo distintos modos | Sistema de alimentación común | Paz, Catriel | Gonzalez, Flor + Cáceres, Luciana + Lopez, Juan + Brites, Agustin
Validación de misión secundaria | Plan de ensayos y criterios de aceptación | Comparación esperado vs. obtenido | Ensayo integrado con movimiento y consumo medido | Todos los sistemas | Todos | Coordinación general

Sheet: Gantt Integrado PDR
CanSat Universitario 2026–2027 — Gantt Integrado de preparación PDR
Vista consolidada de misión principal + misión secundaria. El objetivo es trabajar en paralelo y converger a integración durante las semanas 6–8.
Bloque | Responsable | Tipo | Resultado esperado |  |  |  |  |  |  |  |  | Estado | Observaciones
Requisitos + CONOPS | Todos | Común | Requisitos y operaciones de ambas misiones consolidados | ■ | ■ |  |  |  |  |  |  | En curso
Arquitectura e interfaces | Todos | Común | Arquitectura general e interfaces principal/secundaria/alimentación |  | ■ | ■ |  |  |  |  |  | En curso
Adquisición misión principal | Lopez, Juan + Gonzalez, Flor | Principal | Sensores obligatorios definidos y prototipados |  | ■ | ■ | ■ |  |  |  |  | En curso
Control / software misión principal | Gonzalez, Flor | Principal | Estados internos, reinicios, persistencia, watchdog y control |  | ■ | ■ | ■ | ■ |  |  |  | Planificado
RF + estación terrena | Lopez, Juan + Brites, Agustin | Principal | Enlace bidireccional + telemetría 1 Hz + GCS funcional |  | ■ | ■ | ■ | ■ | ■ |  |  | Planificado
Mecánica / estructura | Cáceres, Luciana | Principal | CAD, masa, materiales, sujeciones y esfuerzos |  | ■ | ■ | ■ | ■ | ■ |  |  | En curso
Descenso / recuperación | Lopez, Maximiliano | Principal | 2 paracaídas, liberación, anclajes y baliza |  | ■ | ■ | ■ | ■ | ■ |  |  | En curso
Alimentación de energía | Paz, Catriel | Común | Batería, regulación, distribución, protecciones, autonomía ≥2 h y monitoreo |  | ■ | ■ | ■ | ■ | ■ |  |  | En curso | Común a misión principal y secundaria
Adquisición secundaria | Lopez, Juan | Secundaria | Magnetómetro + solar + NIR integrados |  | ■ | ■ | ■ | ■ |  |  |  | Planificado
Determinación de actitud | Gonzalez, Flor + Lopez, Juan | Secundaria | Fusión magneto-solar-inercial validada |  |  | ■ | ■ | ■ | ■ |  |  | Planificado
Teledetección VIS/NIR | Brites, Agustin + Lopez, Juan | Secundaria | Captura, alineación y variables multiespectrales |  | ■ | ■ | ■ | ■ | ■ |  |  | Planificado
Clasificación de aterrizaje | Brites, Agustin + Gonzalez, Flor | Secundaria | Algoritmo de aptitud de terreno |  |  | ■ | ■ | ■ | ■ | ■ |  | Planificado
Integración mecánica secundaria | Cáceres, Luciana + Lopez, Juan | Secundaria | Montaje NIR/sensores compatible con estructura y batería |  |  | ■ | ■ | ■ |  |  |  | Planificado
Presupuesto energético secundaria | Paz, Catriel + Gonzalez, Flor + Brites, Agustin | Secundaria | Consumos medio/pico medidos y compatibilidad con alimentación común |  | ■ | ■ | ■ | ■ | ■ | ■ |  | Planificado
Integración hardware/software/energía | Todos | Integración | CanSat preliminar operando como sistema completo |  |  |  |  | ■ | ■ | ■ |  | Planificado
Pruebas integradas | Todos | Integración | Evidencias funcionales y energéticas para PDR |  |  |  |  |  | ■ | ■ |  | Planificado
Masa, energía, costos, riesgos y cronograma | Todos | Común | Presupuestos consolidados y márgenes de diseño |  |  |  |  |  | ■ | ■ |  | Planificado
Presentación PDR | Todos | Común | Diapositivas + revisión cruzada + ensayo |  |  |  |  |  |  | ■ | ■ | Planificado

Sheet: Sistema Alimentacion
Sistema de Alimentación de Energía — Desarrollo preliminar para PDR
Subsistema común a misión principal y secundaria. Responsable principal: Paz, Catriel (IEM 1); apoyo mecánico: Cáceres, Luciana (IEM 4); apoyo software/modos de operación: Gonzalez, Flor (ISI 1).
Ítem | Qué debe definirse | Cálculo / análisis | Prueba preliminar | Responsable | Apoyo | Semana | Estado
Inventario de cargas | Tensión, corriente media, picos y duty-cycle de cada módulo | Potencia media y máxima por subsistema | Medición de consumos representativos | Paz, Catriel | Gonzalez, Flor + Brites, Agustin |  | En curso
Arquitectura eléctrica | Rieles 3.3 V / 5 V u otros, topología y distribución | Mapa de potencia y compatibilidad de tensiones | Prueba de distribución sin carga y con carga | Paz, Catriel | Gonzalez, Flor |  | Planificado
Selección de batería | Química permitida, tensión, capacidad, masa y montaje | Energía requerida para ≥2 h + margen | Prueba de autonomía preliminar | Paz, Catriel | Cáceres, Luciana |  | En curso
Regulación y conversión | Buck/boost/LDO, eficiencia y corrientes máximas | Pérdidas y disipación térmica | Ensayo bajo carga y picos | Paz, Catriel | Cáceres, Luciana |  | Planificado
Protecciones y maniobra | Interruptor accesible, indicador, fusible/protecciones y conectores | Caída de tensión y corriente de protección | Prueba de encendido/apagado y fallas básicas | Paz, Catriel | Cáceres, Luciana |  | Planificado
Monitoreo eléctrico | INA219 y variables de tensión/corriente | Resolución, rango y frecuencia de lectura | Comparación con multímetro/fuente | Paz, Catriel | Gonzalez, Flor |  | Planificado
Fuentes independientes | VBAT del RTC y batería independiente de baliza | Autonomía y aislamiento respecto de batería principal | Prueba ante corte de alimentación principal | Paz, Catriel | Gonzalez, Flor + Lopez, Maximiliano |  | Planificado
Integración física | Ubicación de batería, conversores, cableado y retención | Impacto en masa, centro de masa y volumen | Mockup / fit preliminar | Cáceres, Luciana | Paz, Catriel |  | Planificado
Validación energética | Funcionamiento conjunto de misión principal + secundaria | Autonomía total, margen y picos de consumo | Prueba integrada prolongada | Paz, Catriel | Todos |  | Planificado
Criterio de cierre para PDR: arquitectura eléctrica definida, batería candidata seleccionada, presupuesto energético completo y una prueba preliminar que demuestre funcionamiento bajo cargas representativas.

Sheet: Impacto Anexo A v2
CanSat Universitario 2026–2027 — Impacto de Anexo A v2
Cambios frente al Anexo anterior y efecto en la planificación. Se adopta Anexo A v2 como versión vigente.
Requisito / tema | Cambio vigente | Impacto en planificación | Área afectada | Acción / criterio
S2 — Diámetro | 95 mm → 90 mm | Actualizar CAD, distribución interna y presupuesto geométrico. | IEM / Integración | Diseñar con Ø 90 mm.
X2 — Radio | Se elimina el requisito NetID/PanID; queda prohibición de broadcast. | NetID/PanID deja de figurar como requisito obligatorio. | ISI + IEM 3 | Mantener no-broadcast; NetID/PanID solo si se adopta como decisión de diseño.
X3 — Separación | Nueva redacción: la telemetría deberá enviar un comando automáticamente al separarse del cohete. | Debe revisarse la lógica de inicio/comando asociada al evento de separación. | ISI 1 + ISI 2 | Implementar lógica automática y dejar la semántica exacta como TBR hasta aclaración.
X4 — Frecuencia | Telemetría a 1 Hz (renumerado). | Sin cambio técnico principal. | ISI 1 + ISI 2 | Mantener adquisición/transmisión a 1 Hz.
X5 — Datos de telemetría | Agrega explícitamente aceleraciones y rotaciones en los tres ejes. | El pipeline, GUI y CSV deben incluir IMU 3 ejes además de altitud, presión, temperatura y GPS. | ISI 1 + ISI 2 + IEM 3 | Agregar accel XYZ y gyro XYZ a adquisición, telemetría, visualización y registro.
X6 — Telecomando | Batería y señal solar deben transmitirse mediante telecomando. | Se mantiene necesidad de recepción/procesamiento de telecomandos. | ISI 1 + ISI 2 | Definir comando propio/documentado y respuesta telemétrica.
Sección detallada 3.1 anterior | Ya no aparece en Anexo A v2. | Formato ASCII fijo, lista de STATE, CX/ST/CAL/MEC, OPTIONAL_DATA y nombre Flight_<ID>.csv dejan de tratarse como requisitos del Anexo. | ISI | Conservar solo lo útil como decisión de diseño o si otra fuente vigente lo exige.
F1–F5 — Software de vuelo | Se mantienen. | Persistencia de contador, tiempo y configuración ante reinicios sigue siendo obligatoria. | ISI 1 | Mantener diseño de memoria no volátil, RTC/referencia temporal y recuperación tras reinicio.
G1–G15 — Estación terrena | Se mantienen. | CSV, GUI, gráficos, conteo de paquetes y telecomandos siguen vigentes. | ISI 2 | No eliminar estas tareas del plan.
