florensg/cansat-utn-frre/hardware/cad/Compartimento 1.SLDPRT

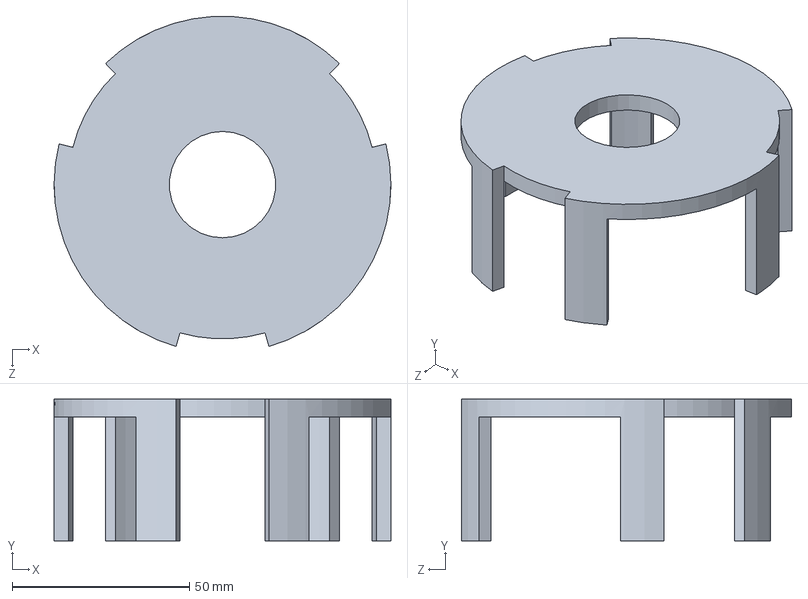
[picture p31: CAD file, 2026-10-31]
hardware/cad/Compartimento 1.SLDPRT
95.0 x 40.0 x 93.1 mm
