florensg/cansat-utn-frre/hardware/cad/Esqueleto 1.SLDPRT

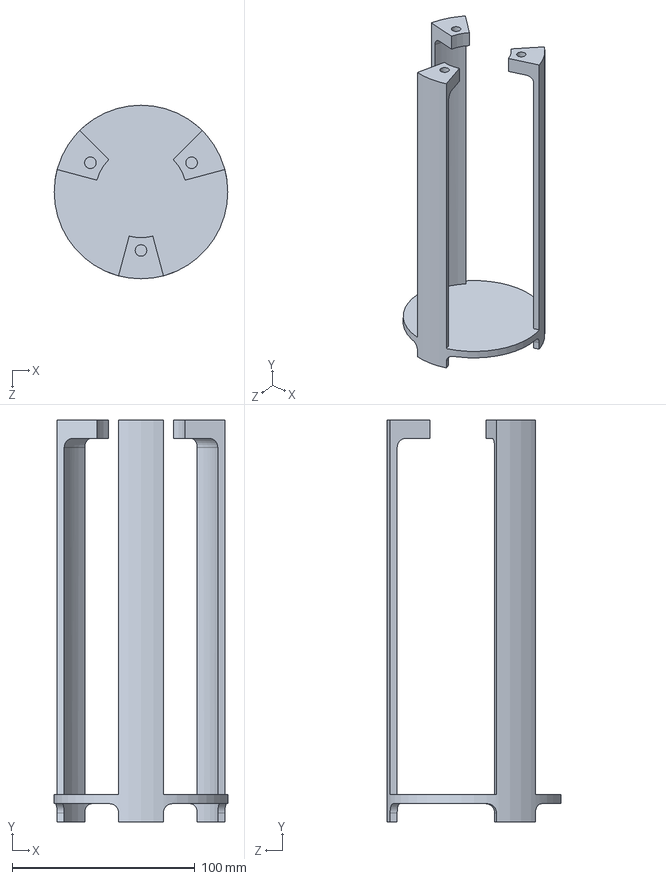
[picture p32: CAD file, 2026-10-31]
hardware/cad/Esqueleto 1.SLDPRT
95.0 x 220.0 x 95.0 mm
