florensg/cansat-utn-frre/hardware/cad/Tapa 1.SLDPRT

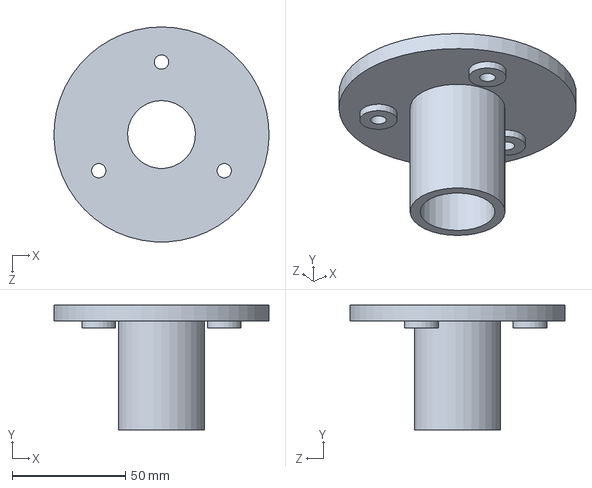
[picture p33: CAD file, 2026-10-31]
hardware/cad/Tapa 1.SLDPRT
95.0 x 55.0 x 95.0 mm
