florensg/cansat-utn-frre/hardware/cad/Ensamblaje 1.SLDASM

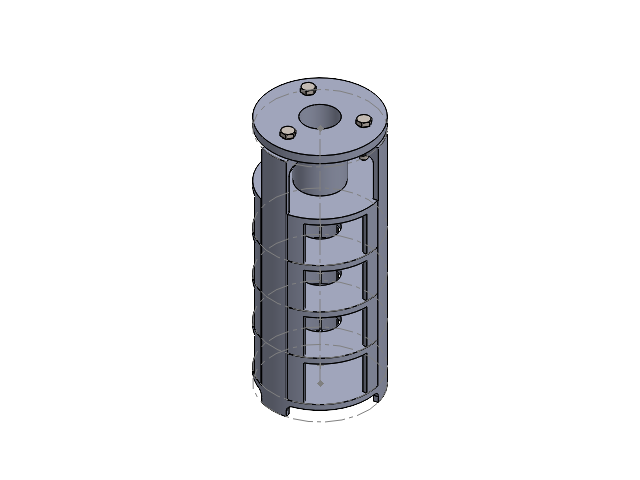
[picture p34: CAD file, 2026-10-31]
hardware/cad/Ensamblaje 1.SLDASM
Esqueleto 1
Compartimento 1 x 4
Tapa 1
hex cap screw_am x 3
prevailing torque hex nut_am x 3
