florensg/cansat-utn-frre/docs/04-pruebas/evidencias/README.md

# Evidencias de ensayos

Guardar aquí los logs, capturas y archivos de resultados con el formato
`AAAA-MM-DD_descripcion.ext`.

Cada evidencia debe estar referenciada desde la matriz de
[`docs/04-pruebas/README.md`](../README.md).
