florensg/cansat-utn-frre/hardware/proteus/CanSat/PROPUESTA DE CIRCUITO CANSAT.pdf

1

## RPI1

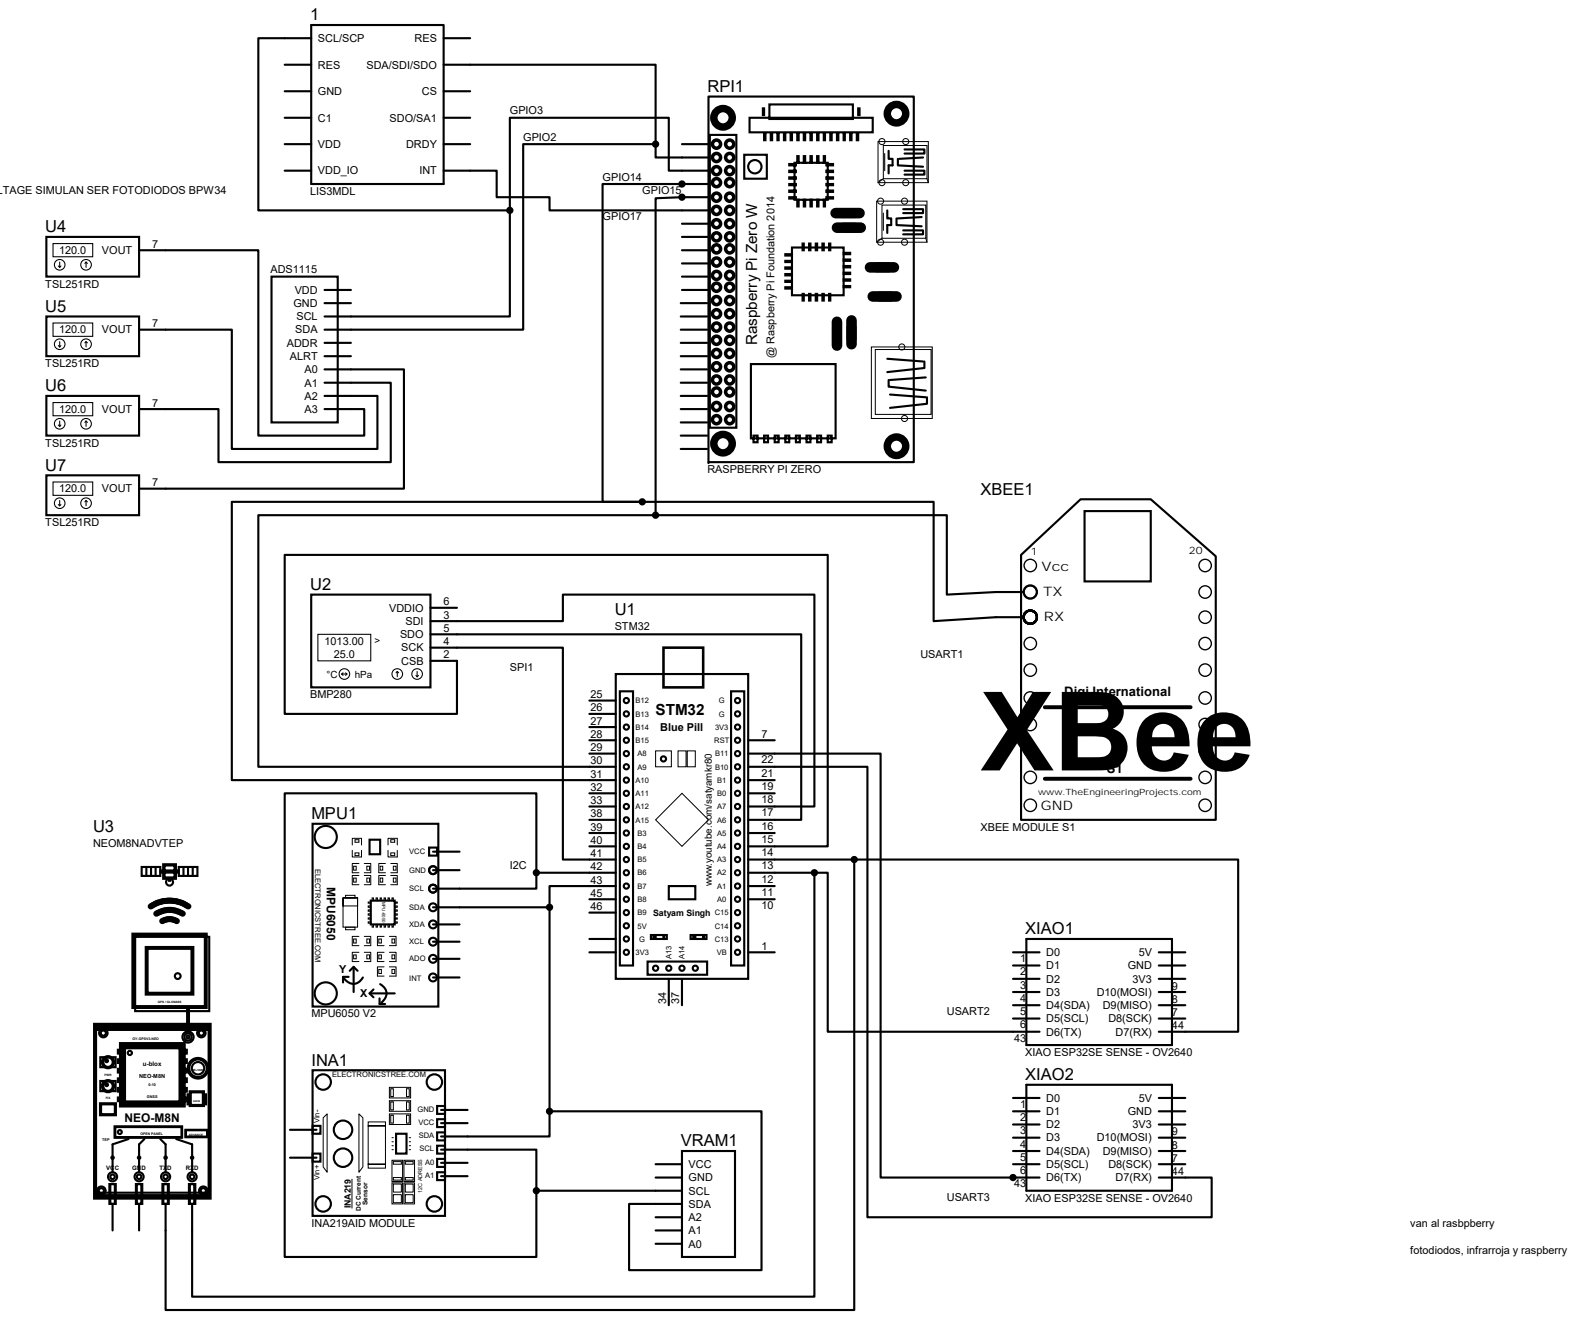
[picture p35: page 1]

LTAGE SIMULAN SER FOTODIODOS BPW34

13 | XIAO1
12

OPEN PANEL | ADVANCE
