florensg/cansat-utn-frre/docs/02-arquitectura/PROPUESTA_DE_CIRCUITO_CANSAT_v3.pdf

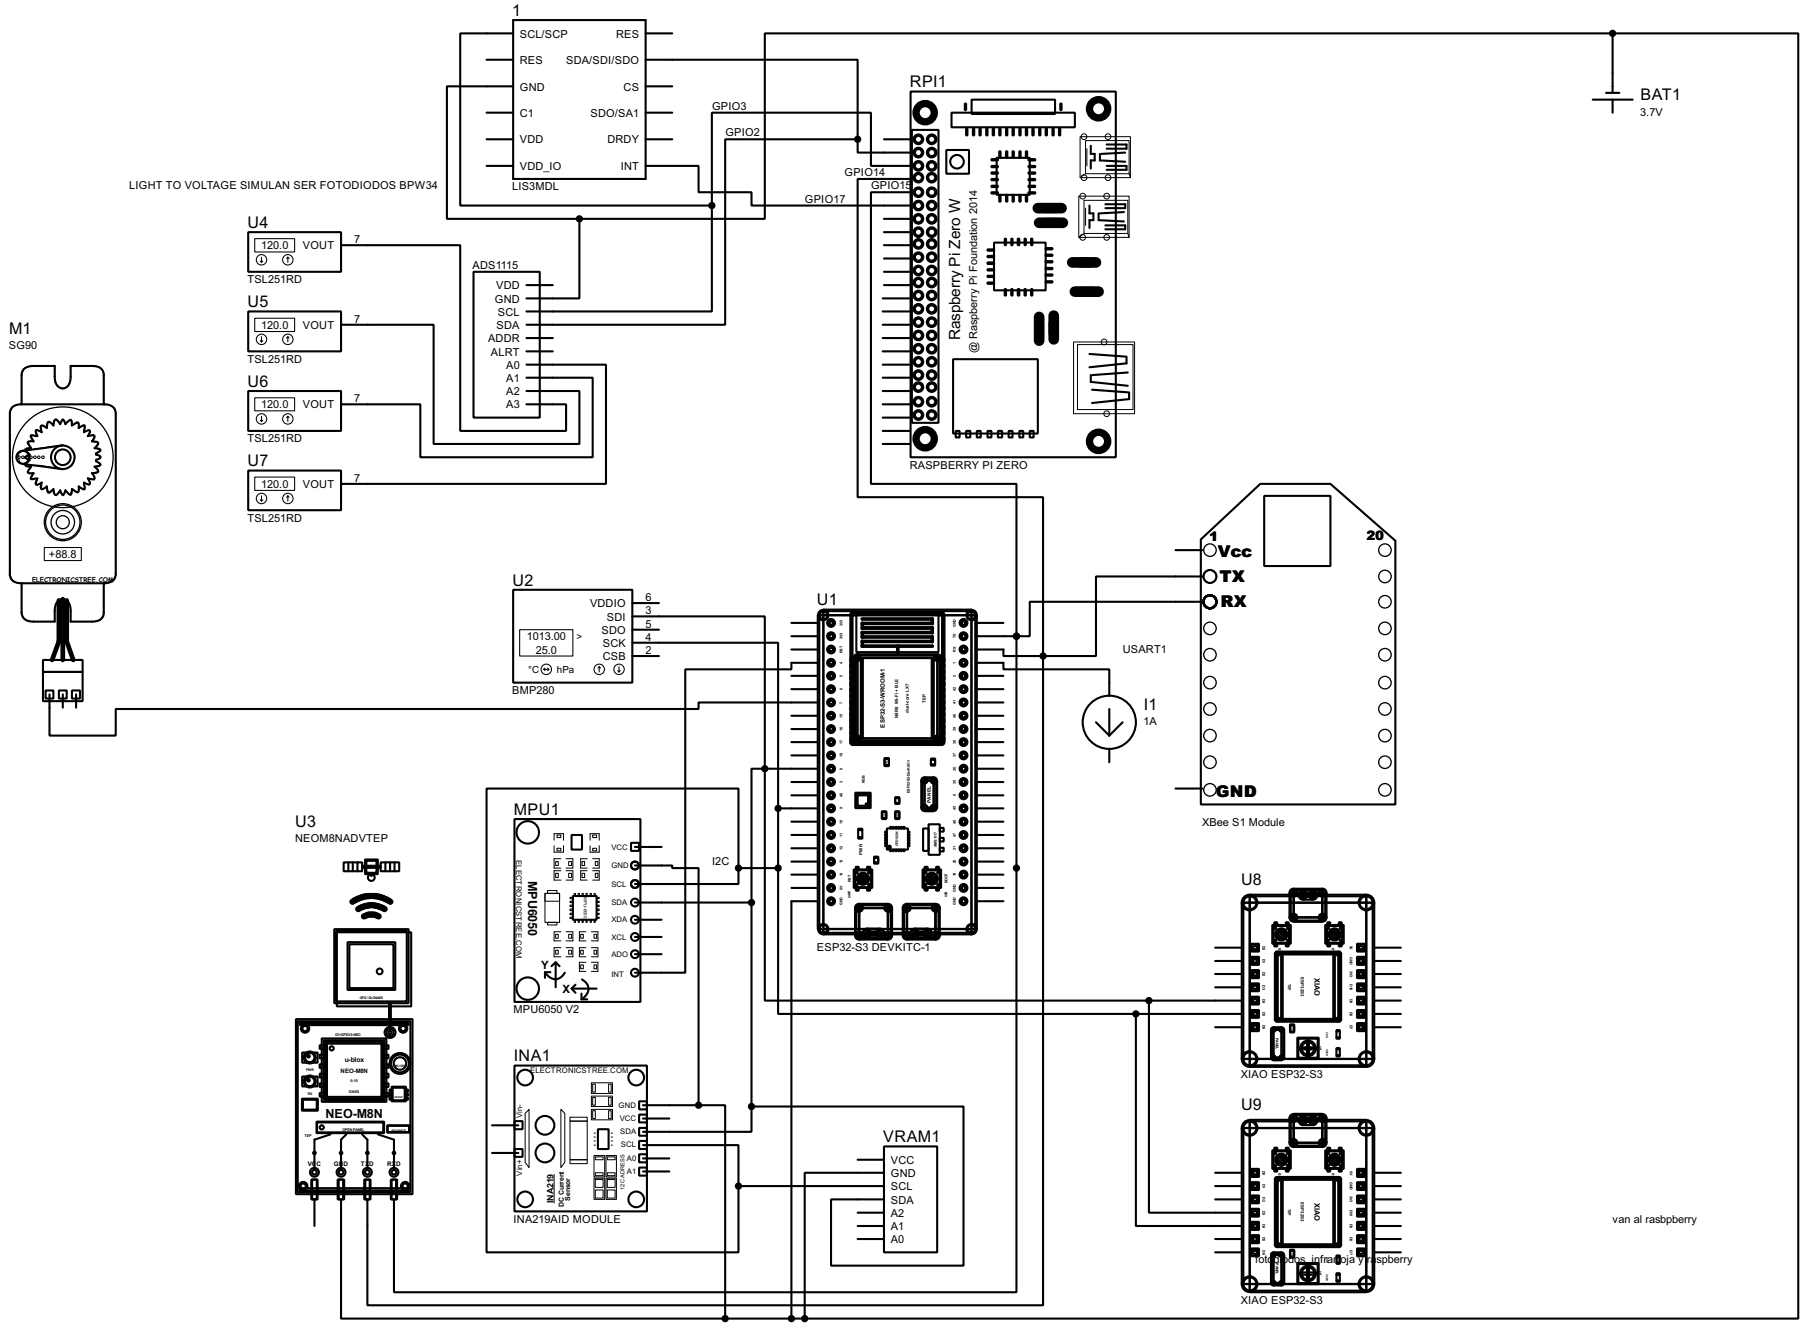
[picture p36: page 1]
