florensg/cansat-utn-frre/(list of files, drawings)

Other design files:
hardware/proteus/CanSat/esp32 ai cam.pdsprj
hardware/proteus/CanSat/LIS3MDL.pdsprj
hardware/proteus/CanSat/MB85RC256V.pdsprj
hardware/proteus/CanSat/proyecto cansat.pdsprj
