florensg/cansat-utn-frre/(commit log)

2026-10-31 chore(repo): bootstrap monorepo y base de software de vuelo ISI 1
    [Compartimento 1.SLDPRT, Ensamblaje 1.SLDASM, Esqueleto 1.SLDPRT, LIS3MDL.pdsprj, MB85RC256V.pdsprj, Scoresheet V2.xlsx, Tapa 1.SLDPRT, elementos-cansat-v2.xlsx]
2026-10-31 feat(obc): migrar controlador principal a ESP32-S3 DevKitC-1
    [elementos-cansat.xlsx, planificacion-general-v2.xlsx]
2026-10-31 feat(sim): agregar configuracion Wokwi para ESP32-S3
2026-11-04 feat(sim): agregar circuito interactivo Wokwi Online, vuelo simulado y guia de pruebas
2026-11-10 feat(arch,firmware,sim): alinear arquitectura a propuesta 2/v3 e integrar modulos OBC, RPi y XIAO
    - Incorporar esquemas y sugerencias de diseno de circuito v3 en docs/02-arquitectura
    - Actualizar configuracion de pines, buses SPI/I2C y telemetria en firmware/obc-esp32s3
    - Agregar firmware base para camaras secundarias en firmware/payload-xiao
    - Actualizar scripts de adquisicion y sensores del payload RPi Zero W
    - Reorganizar entorno de simulacion Wokwi en carpeta simulacion/
    - Incluir guia interactiva de codigo para el equipo y documentacion de arquitectura
